bcj2307/Phase-encoding-a-reflector-array-using-open-and-short-circuited-loads/Report/LTSBEN001_Dissertation/Appendices/Repositories.tex

% ----------------------------------------------------
% Proofs
% ----------------------------------------------------
%\documentclass[class=report,11pt,crop=false]{standalone}
%\input{../Style/ChapterStyle.tex}
%\begin{document}
% ----------------------------------------------------
\chapter{Repository Locations}
% ----------------------------------------------------
All code designed for this project can be found at the following link:

\begin{center}
    \url{https://github.com/bcj2307/Phase-encoding-a-reflector-array-using-open-and-short-circuited-loads/tree/main/MATLAB}
\end{center}

\vspace{1cm}

All CST simulation used for the antenna design for this project can be found at the following link:

\begin{center}
    \url{https://github.com/bcj2307/Phase-encoding-a-reflector-array-using-open-and-short-circuited-loads/tree/main/CST}
\end{center}

\vspace{1cm}

All Altium files used for the manufacturing of the antenna can be found at the following link:

\begin{center}
    \url{https://github.com/bcj2307/Phase-encoding-a-reflector-array-using-open-and-short-circuited-loads/tree/main/Altium}
\end{center}

\vspace{1cm}

Furthermore, the \LaTeX~source code for this report, as well as the SVG and PDF diagrams that were designed and included, can be found at:

\begin{center}
    \url{https://github.com/bcj2307/Phase-encoding-a-reflector-array-using-open-and-short-circuited-loads/tree/main/Report}
\end{center}
% ----------------------------------------------------
\ifstandalone
% \bibliography{../Bibliography/References.bib}
% \printnoidxglossary[type=\acronymtype,nonumberlist]
\fi
%\end{document}
% ----------------------------------------------------
