bcj2307/Phase-encoding-a-reflector-array-using-open-and-short-circuited-loads/Report/LTSBEN001_Dissertation/FrontMatter/Title.tex

\thispagestyle{empty}
\begin{center}
    
\Huge

\vspace{5cm}

% Title
Phase encoding a reflector array using open and short-circuited loads

\vspace{2.5cm}

% UCT logo
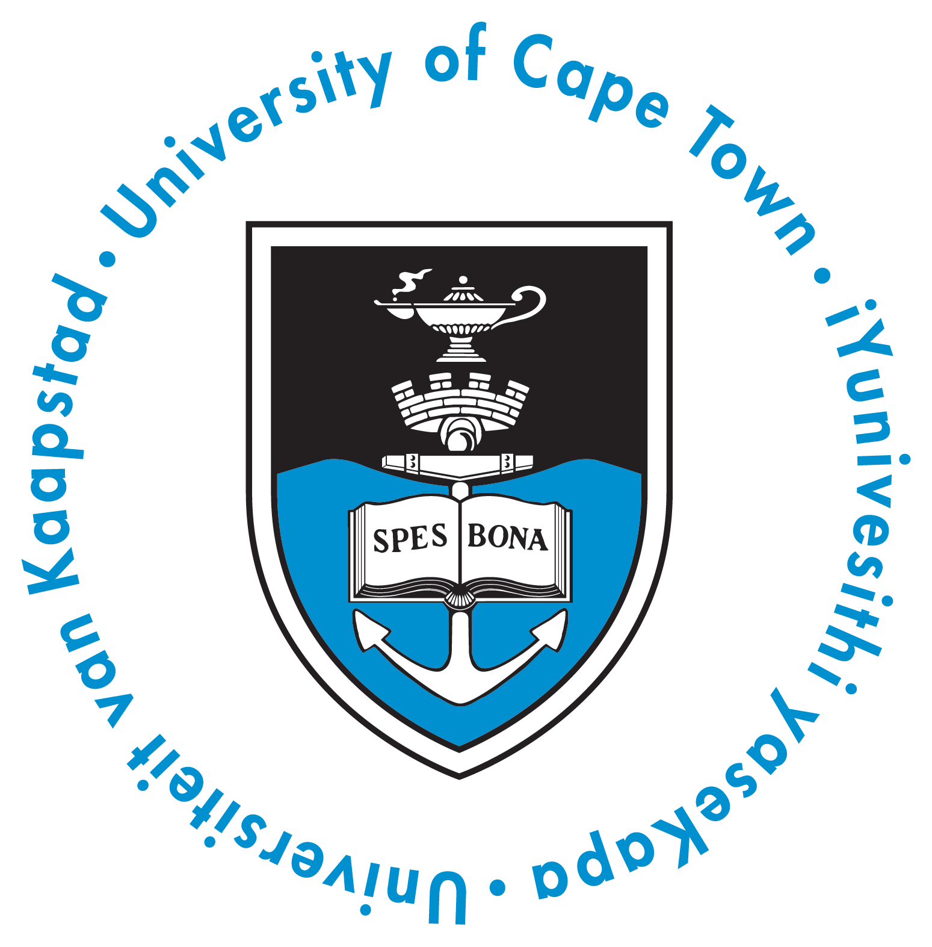
[picture p65: Report/LTSBEN001_Dissertation/FrontMatter/UCT_logo.png]


\vfill

% My name
\large
\textbf{Prepared by:}\\
Benco Loots

\vspace{1cm}

% My supervisor's name
\textbf{Prepared for:}\\
Dr Stephen Paine\\
Department of Electrical Engineering\\
University of Cape Town

\vspace{2cm}

% My Degree
\small
Submitted to the Department of Electrical Engineering at the University of Cape Town\\
in partial fulfilment of the academic requirements for a\\
MEng Master of Engineering Specialising in Radar

\vspace{2cm}

% Today's date
\today

% To add keywords?
% \vspace{2cm}
% \textbf{Keywords:} Passive Radar, Digital Audio Broadcasting

\end{center}
