bcj2307/Phase-encoding-a-reflector-array-using-open-and-short-circuited-loads/Report/LTSBEN001_Dissertation/Main.tex

\documentclass[11pt]{report}
\input{Style/ChapterStyle.tex}
\usepackage{standalone} % Best loaded last in the preamble
\usepackage{float}

\begin{document}

\pagenumbering{roman}
\input{FrontMatter/Title.tex}
\input{FrontMatter/Declaration.tex}
\input{FrontMatter/Acknowledgements.tex}
\input{FrontMatter/Abstract.tex}
\glsresetall

\tableofcontents
\listoffigures
\listoftables

%\input{FrontMatter/Glossary.tex}
%\printnoidxglossary[type=\acronymtype,nonumberlist,title={Abbreviations}]
\input{FrontMatter/Abbreviations}

\newpage

\pagenumbering{arabic}

\input{Chapters/Introduction.tex}
\input{Chapters/Literature.tex}
\input{Chapters/Design.tex}
\input{Chapters/Results.tex}
\input{Chapters/Conclusions.tex}
%\input{Chapters/Recommendations.tex}

\newpage
\bibliography{Bibliography/References.bib}

\appendix
\input{Appendices/Repositories.tex}

%\input{Appendices/Proofs.tex}

\end{document}
