bcj2307/Phase-encoding-a-reflector-array-using-open-and-short-circuited-loads/Report/LTSBEN001_Dissertation/Appendices/Proofs.tex

% ----------------------------------------------------
% Proofs
% ----------------------------------------------------
%\documentclass[class=report,11pt,crop=false]{standalone}
%\input{../Style/ChapterStyle.tex}
%\input{../FrontMatter/Glossary.tex}
%\begin{document}
% ----------------------------------------------------
\chapter{MATLAB Script\label{sec:MATLAB}}
% ----------------------------------------------------

% ----------------------------------------------------
\ifstandalone
% \bibliography{../Bibliography/References.bib}
\printnoidxglossary[type=\acronymtype,nonumberlist]
\fi
%\end{document}
% ----------------------------------------------------
