bcj2307/Phase-encoding-a-reflector-array-using-open-and-short-circuited-loads/Report/LTSBEN001_Dissertation/Figures/chp3_CPW_edge_port.png

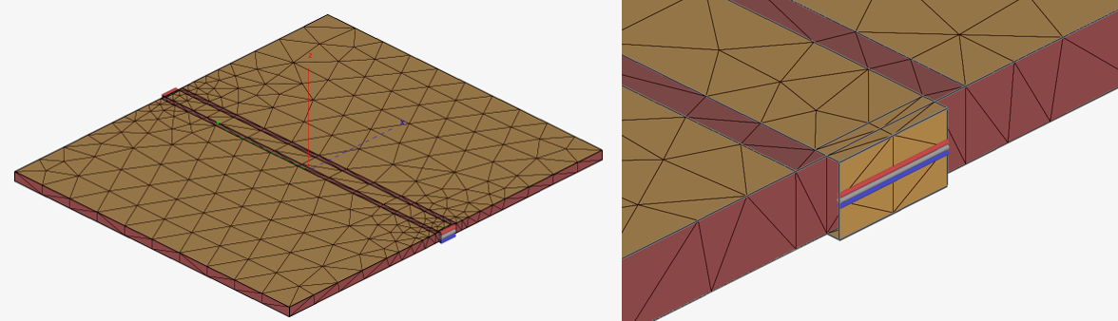
Report/LTSBEN001_Dissertation/Figures/chp3_CPW_edge_port.png
