bcj2307/Phase-encoding-a-reflector-array-using-open-and-short-circuited-loads/Report/LTSBEN001_Dissertation/Figures/chp3_linear_array.png

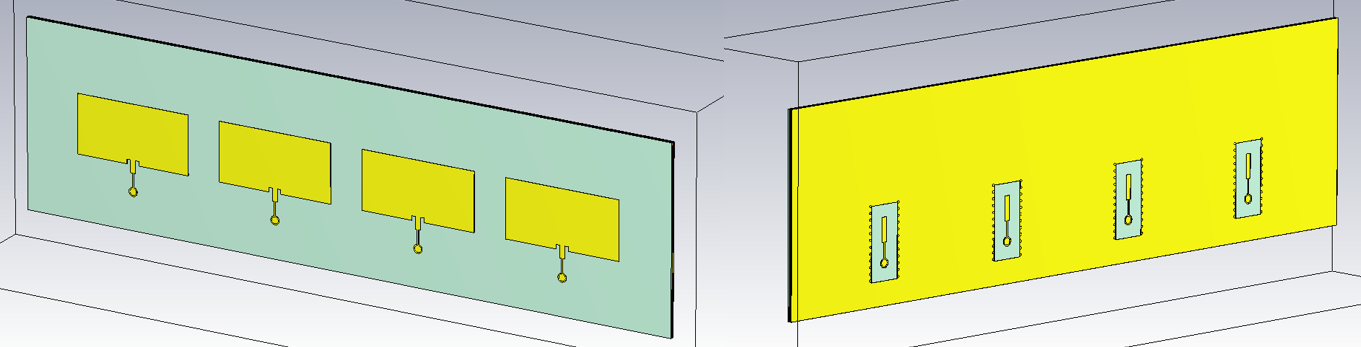
Report/LTSBEN001_Dissertation/Figures/chp3_linear_array.png
