bcj2307/Phase-encoding-a-reflector-array-using-open-and-short-circuited-loads/Report/LTSBEN001_Dissertation/Figures/chp3_linear_array_adjacent_coupling.png

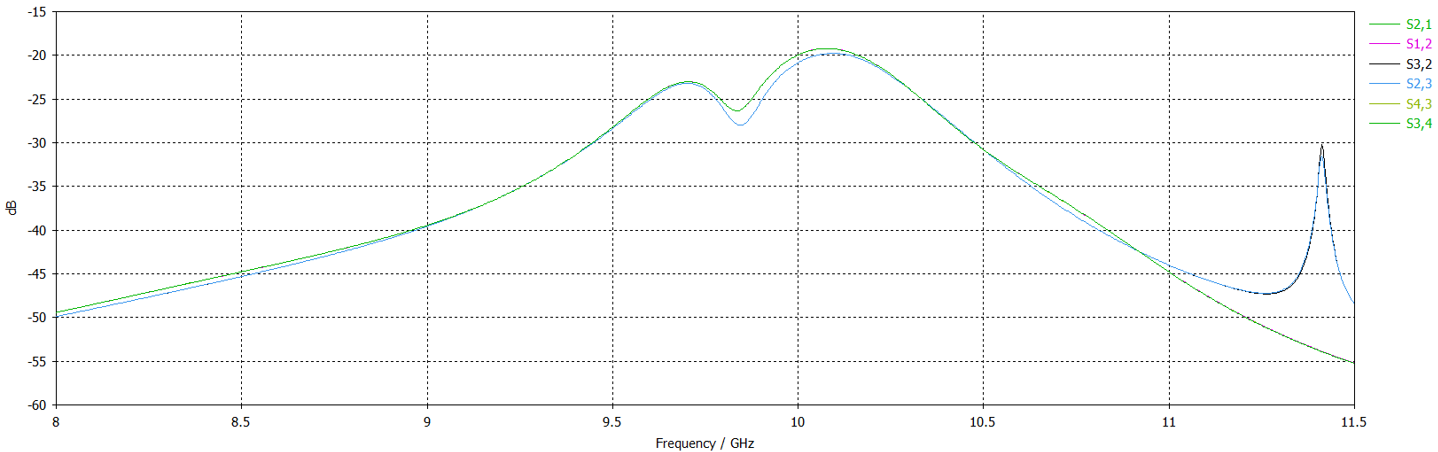
Report/LTSBEN001_Dissertation/Figures/chp3_linear_array_adjacent_coupling.png
