bcj2307/Phase-encoding-a-reflector-array-using-open-and-short-circuited-loads/Report/LTSBEN001_Dissertation/Figures/chp4_Raw_phase.png

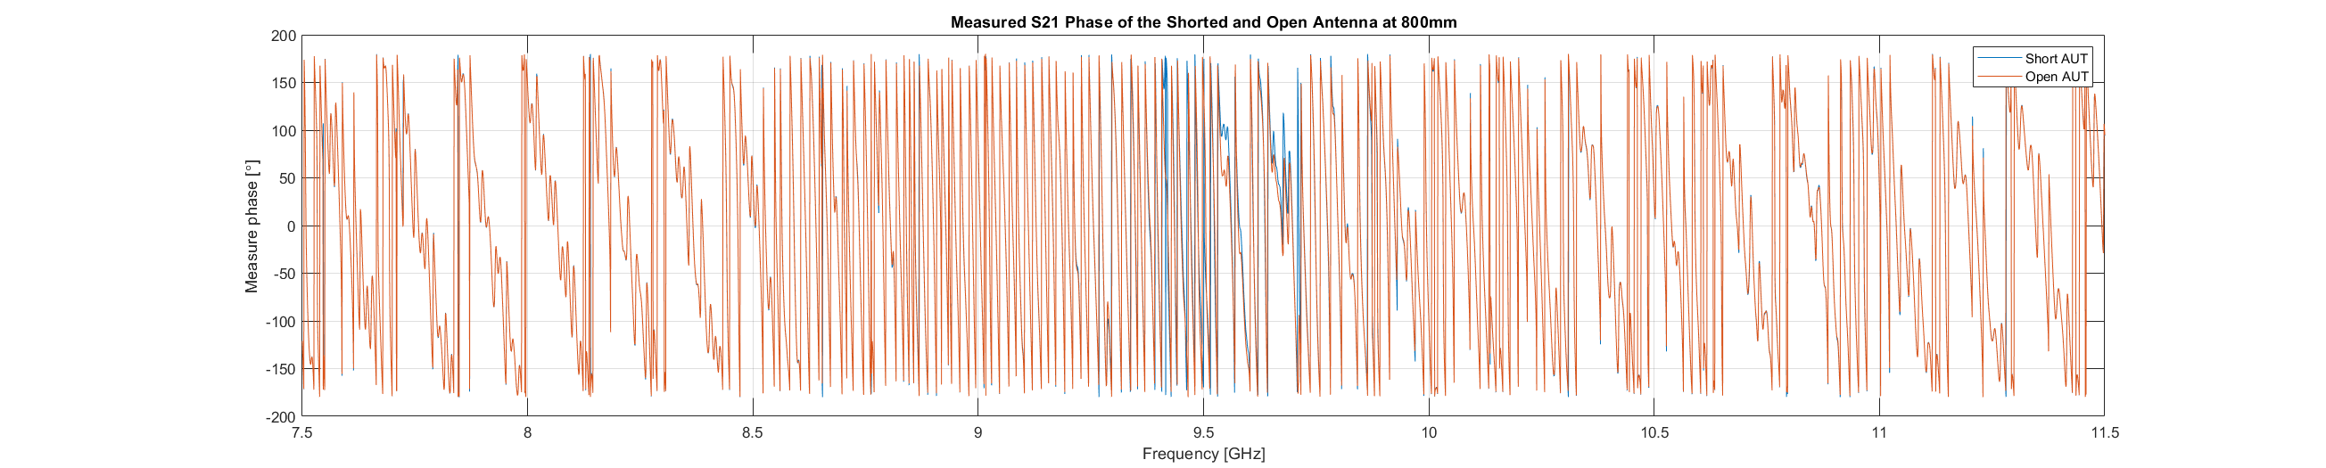
Report/LTSBEN001_Dissertation/Figures/chp4_Raw_phase.png
