bcj2307/Phase-encoding-a-reflector-array-using-open-and-short-circuited-loads/Altium/02 - Manufacturing/EQ for EEE5004ZAntenna.xls

Sheet: DFM
Engineering Questions Confirm Letter
(PN): |  | EEE5004Z Antenna |  | (JOB): |  | M450239
(Linkman): |  | Dave |  | (Date): |  | 2025-03-11 14:10:06
Note: in order to ensure product delivery time, please confirm and reply in a timely manner.Thank you very much!
(Item) | (EQ Type) | (Question Describe) | (Suggestion) | (Annex) | (Customer Reply) |  | (Customer remarks)
2 | Copper | The designed copper extends to the edge of the board. It will cause copper exposure and burr if we follow Gerber. | Suggestion A: Shave copper 0.25mm away from the outline to avoid copper exposure. Suggestion B: Follow Gerber to build, exposed copper and burr are both acceptable. Please choose A or B, the one you think is better. | 2.JPG | A
3 | stamp hole | As shown in the "3.JPG", the stamp holes are on the copper foil of the L3 and L4 layers. Please confirm how to deal with it? | Allow us to shave copper 0.2mm away from the stamp holes to avoid copper exposure. | 3.JPG | Accepted
5 | Gold thickness | The surface treatment thickness is 0.005mm in your stackup. This gold thickness is too thick and we cannot achieve it. We recommend following the IPC 4552 standard, with a gold thickness of 2-4U" and a nickel thickness of 118-236U". Please confirm. | Follow the IPC 4552 standard, and the gold thickness 2-4U" and nickel thickness of 118-236U" is approved. | 5.JPG | Accepted
8 | solder mask | It requires to print white solder mask on the bottom side, but there is no solder mask file in your provided Gerber. Please confirm. | Ignore the solder mask requirements, does not print solder mask ink for this board. | 8.JPG | Accepted
9 | Working Gerber | Please help confirm the attached working Gerber. | Our working Gerber is approved, and we will follow it to build the board. |  | Accepted
Please update your original gerber in archive if adjustments of gerber design involved base on above communication results. Thanks!
IF a customer can not reply EQ betore 12 pm the day after order release date. the lead time calculation will start ftom the next day of EQ closure.

Sheet: 3.JPG
返回（Return） EQs
原稿 | 削铜后的效果如下图所示（注意削铜后的连接位上铜皮断开的）

Sheet: 5.JPG
返回（Return） EQs

Sheet: 8.JPG
返回（Return） EQs
