bcj2307/Phase-encoding-a-reflector-array-using-open-and-short-circuited-loads/Report/LTSBEN001_Dissertation/Chapters/Results.tex

% ----------------------------------------------------
% Theory
% ----------------------------------------------------
%\documentclass[class=report,11pt,crop=false]{standalone}
%\input{../Style/ChapterStyle.tex}
%\input{../FrontMatter/Glossary.tex}
%\begin{document}
\ifstandalone
\tableofcontents
\fi
% ----------------------------------------------------
\chapter{Testing \& Results \label{ch:results}}
%\epigraph{Nobody can build you the bridge over which you must cross the river of life, nobody but you alone.}%
%    {\emph{---Friedrich Nietzsche}}
\vspace{0.5cm}
% ----------------------------------------------------

\section{Test setup \& Equipment}

    \begin{figure}[H]
    \centering
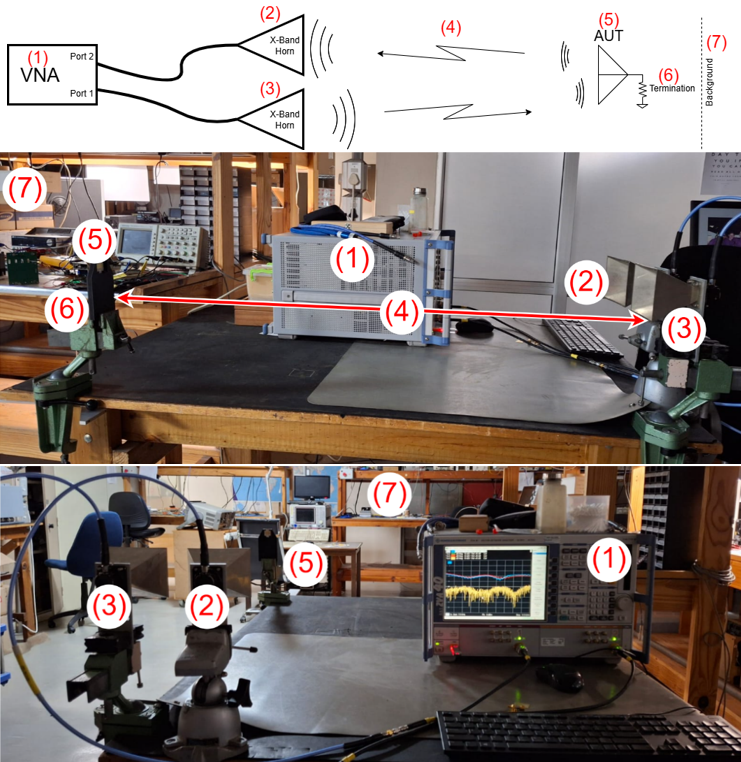
[picture p83: Report/LTSBEN001_Dissertation/Figures/chp4_setup.png]
    
    \caption{Test Setup.}
    \label{fig:chp4_setup}
    \end{figure}

Figure \ref{fig:chp4_setup} show the labelled block diagram of the test setup along with the labelled physical test setup used for all the measurements in this section.
\begin{enumerate}
    \item The Rohde \& Schwarz ZVA 40 VNA was used. This a 2 port \(10MHz-40GHz\) VNA.
    \item This is one of two identical reflective covered injection moulded X-band horn antennae. This antenna acts as the transmit antenna. Since the signal measured will be extremely small in magnitude a horn antenna was chosen for the high gain and directivity.
    \item This is the other X-band horn antennae that was used as the receive antenna. The center of the aperture of the horn antennae are aligned.
    \item The AUT must be placed in the Farfield region of all the antennae. Since the X-Band horn antenna have the largest aperture, the min distance will be the were the Farfield of the horn antennae start.
    \item The AUT is placed in the design bracket and the bracket does not move for a set of measurements. The bracket is designed to keep the position of the AUT fixed when swapping the antennae. The center of the patch is aligned with the aperture of the horn antennae.
    \item Instead of changing the termination of each measurement, three different antennae are used with a termination connect. See figure \ref{fig:chp4_AUTs} below.
    \item Since the measurement were done in the laboratory of a Radar company, the measurements were done after hours and all other equipment in the laboratory was switched off. 
\end{enumerate}

    \begin{figure}[H]
    \centering
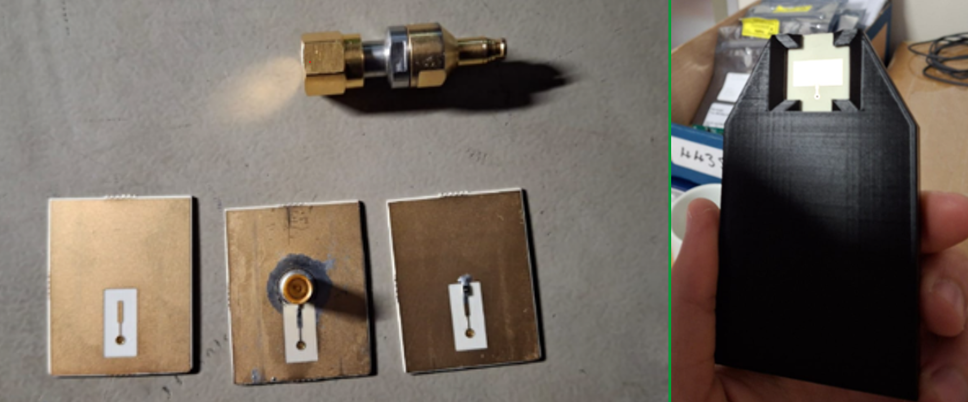
[picture p84: Report/LTSBEN001_Dissertation/Figures/chp4_AUTs.png]
    
    \caption{Three different AUT used during testing.}
    \label{fig:chp4_AUTs}
    \end{figure}

Before the investigation can be done with the design patch antenna, the antenna design must first be verified. The measured return loss of the connectorized antenna is seen in figure \ref{fig:chp4_AUT_S11} below. Although the deep null of -40dB is not seen, the return loss of -19.5dB at the center frequency is still a well-designed antenna. The center frequency is also lower by a 98MHz which equates to a difference in antenna width of $\pm$200um or antenna length of $\pm$90um according to CST studio simulations.

    \begin{figure}[H]
    \centering
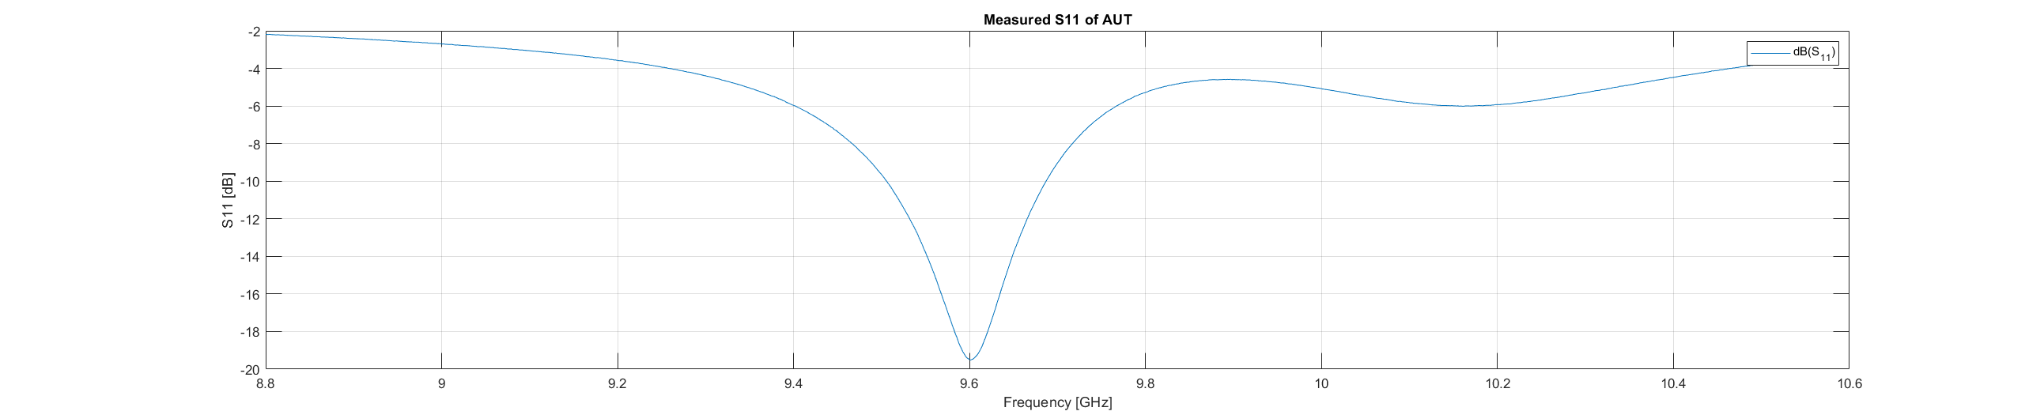
[picture p85: Report/LTSBEN001_Dissertation/Figures/chp4_AUT_S11.png]
    
    \caption{Measured return loss of the design patch (AUT).}
    \label{fig:chp4_AUT_S11}
    \end{figure}

\section{Results}
The test procedure involves moving the AUT into the Farfield of the X-Band horn antennae then doing three separate measurements. One with the open load antenna, a second with the short-circuited antenna a third with the SMP antenna with a SMA 50Ω termination connected to it. The Farfield region of the X-Band horn is calculated below as 584mm. At set of measurements were done with the AUT 600mm, 700mm, 800mm and 900mm away from the horn antennae.
    \[R_{ff}=\frac{2D^2}{\lambda}=\frac{2{(95mm)}^2}{30.91mm}=584mm\]

Analyzing the raw \(S_{21}\) data for the 800mm measurements, as seen in figure \ref{fig:chp4_Raw_results} below, the measured magnitude is the same for both the short circuit and the open circuit AUT. The only visible difference is near the center frequency of the AUT. The same is seen in figure \ref{fig:chp4_Raw_results} for the measured \(S_{21}\) phases of the short circuit and open circuit AUT. 

    \begin{figure}[H]
    \centering
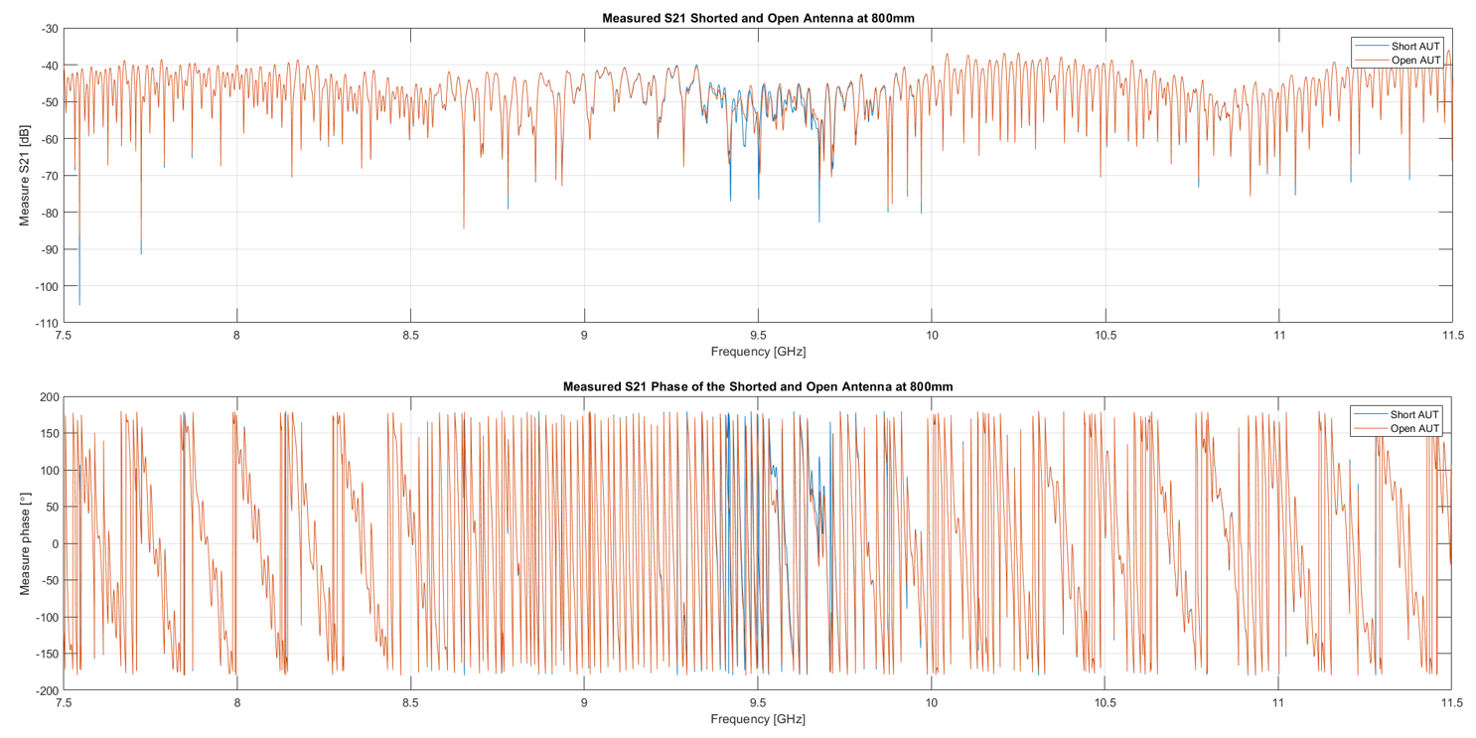
[picture p86: Report/LTSBEN001_Dissertation/Figures/chp4_Raw_results.png]
    
    \caption{Measured \(S_{21}\) magnitude \& phase.}
    \label{fig:chp4_Raw_results}
    \end{figure}

Figure \ref{fig:chp4_Raw_difference_results} below show the zoomed-in view of figure \ref{fig:chp4_Raw_results} as well as the phase difference between the short circuit and open circuit AUT of the measured and unprocessed \(S_{21}\). It is clear that the maximum difference occurs close to the center frequency, which is the opposite response that is aimed for. The following section details the results of the signal processing required for the proposed system in section \ref{sec:objectives}.

    \begin{figure}[H]
    \centering
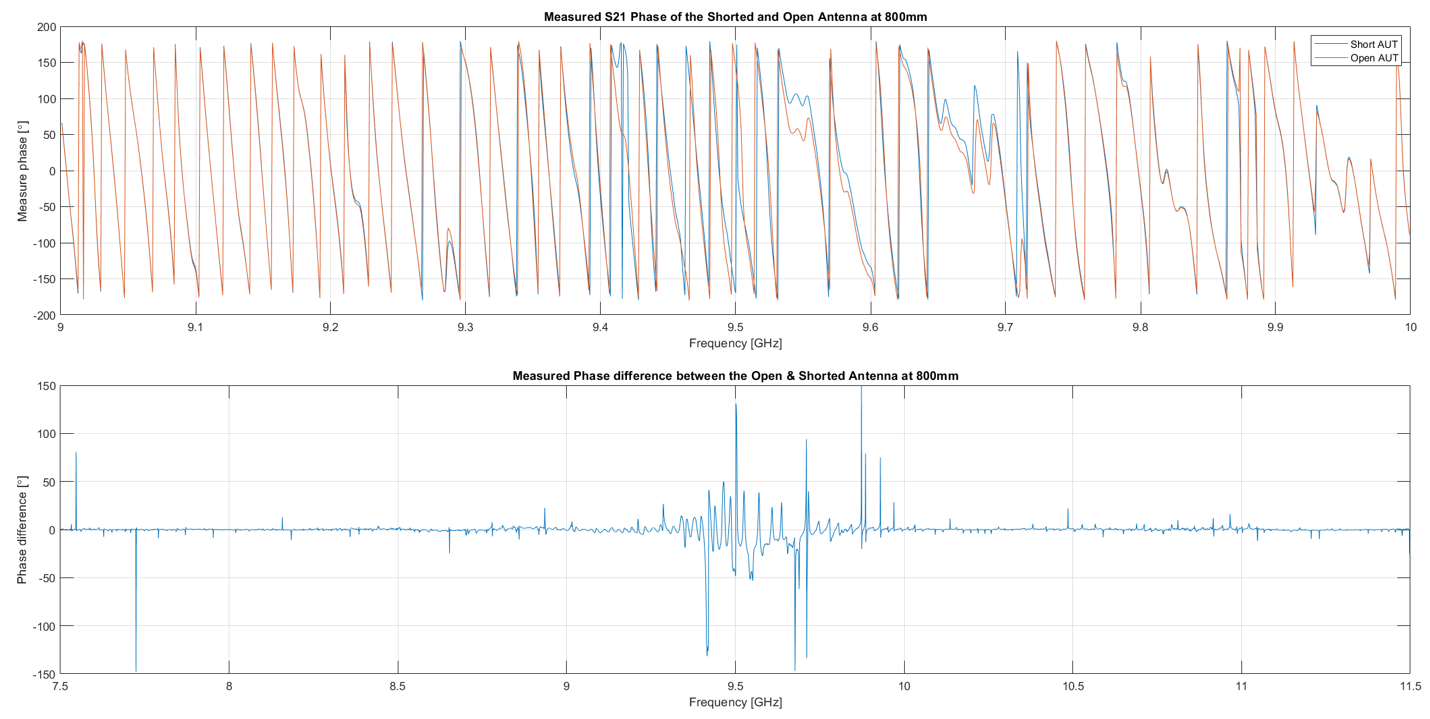
[picture p87: Report/LTSBEN001_Dissertation/Figures/chp4_Raw_difference_results.png]
    
    \caption{Measured and unprocessed phase difference between the open and short AUT.}
    \label{fig:chp4_Raw_difference_results}
    \end{figure}

Figure \ref{fig:chp4_Raw_smith} below shows the \(S_{21}\) at the center frequency plotted on the smith chart. Since the power loss from the transmit horn antenna through the test setup to the receive antenna is high, the magnitude of the \(S_{21}\) is very low. Due to this all three \(S_{21}\) points are difficult to see, figure \ref{fig:chp4_Raw_smith} (bottom) shows the same plot with a scale of 0.0032.

    \begin{figure}[H]
    \centering
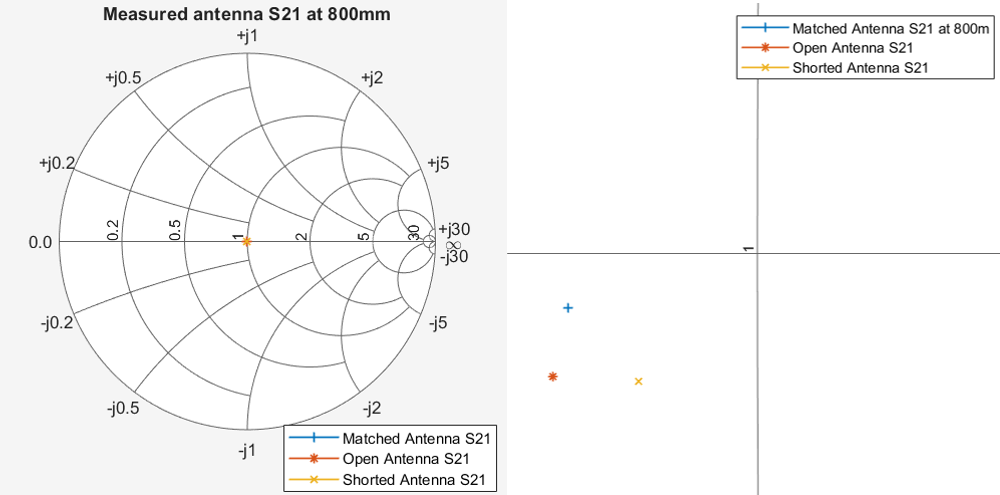
[picture p88: Report/LTSBEN001_Dissertation/Figures/chp4_Raw_smith.png]
    
    \caption{Measured and unprocessed \(S_{21}\) plotted on the smith chart.}
    \label{fig:chp4_Raw_smith}
    \end{figure}

For the proposed system in section \ref{sec:objectives}, it is assumed that the background and physical AUT remains constant for a given measurement. If that this assumption holds true, then the reflections received from the scene will be the same in the short circuit and open circuit measurement. Therefor this can be calibrated out. For the testing in this report the matched AUT should absorb all the received power into the 50$\Omega$ load and the received signal should only contain the reflections from the background and the physical structure of the AUT. Therefor all the measured \(S_{21}\) data is normalized to the matched \(S_{21}\) data as seen in figure \ref{fig:chp4_Calibrated_smith} below.

    \begin{figure}[H]
    \centering
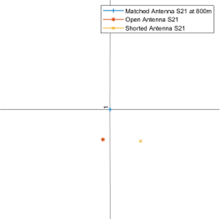
[picture p89: Report/LTSBEN001_Dissertation/Figures/chp4_Calibrated_smith.png]
    
    \caption{\(S_{21}\) normalized to the \(50\Omega S_{21}\) plotted on the smith chart.}
    \label{fig:chp4_Calibrated_smith}
    \end{figure}

Now that the short circuit and open circuit \(S_{21}\) has been normalized, the phase difference can be recalculated. Figure \ref{fig:chp4_Calibrated_difference_warpped_results} below shows the result over the entire measured frequency span. The spikes observed are due to the phase wrapping. Figure \ref{fig:chp4_Calibrated_difference_warpped_results}(bottom) show the result over the over the entire measured frequency span with the unwrapped phase.

    \begin{figure}[H]
    \centering
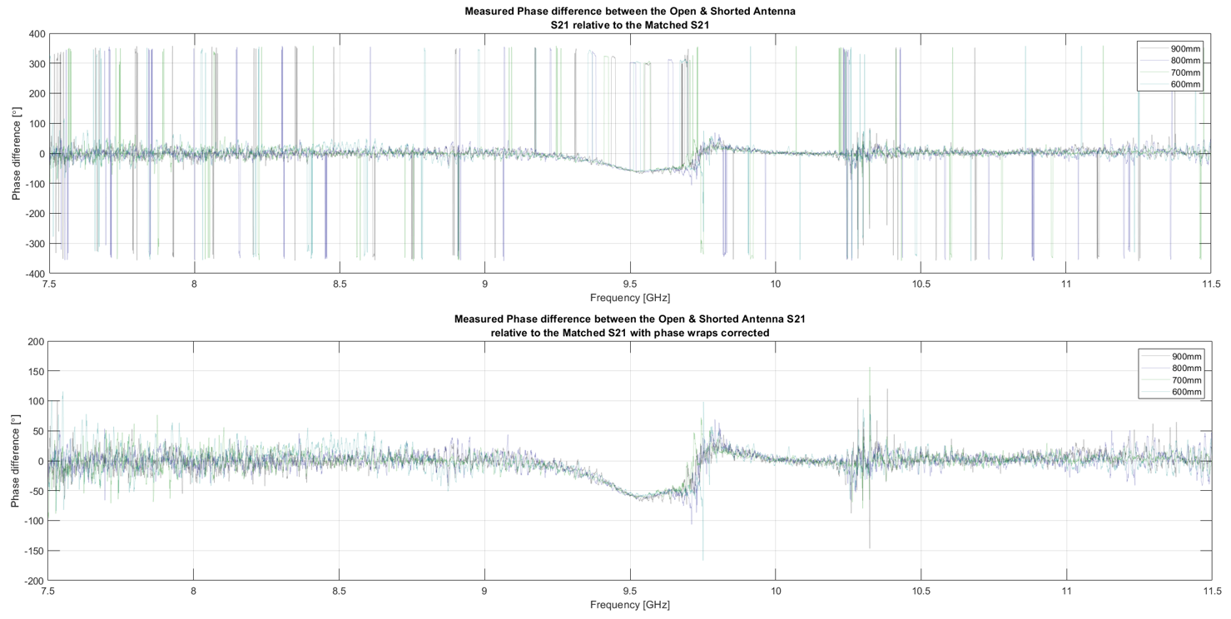
[picture p90: Report/LTSBEN001_Dissertation/Figures/chp4_Calibrated_difference_warpped_results.png]
    
    \caption{Encoded phase difference of the AUT normalized to the \(50\Omega \ S_{21}\).}
    \label{fig:chp4_Calibrated_difference_warpped_results}
    \end{figure}

It is undeniable that the phase difference becomes smaller the closer the measurement is to the center frequency. Figure \ref{fig:chp4_Calibrated_difference_zoom} below shows a zoomed-in plot of the phase difference. Using the antenna parameters as a guide the error calculations are done from 9.425-9.575GHz.

    \begin{figure}[H]
    \centering
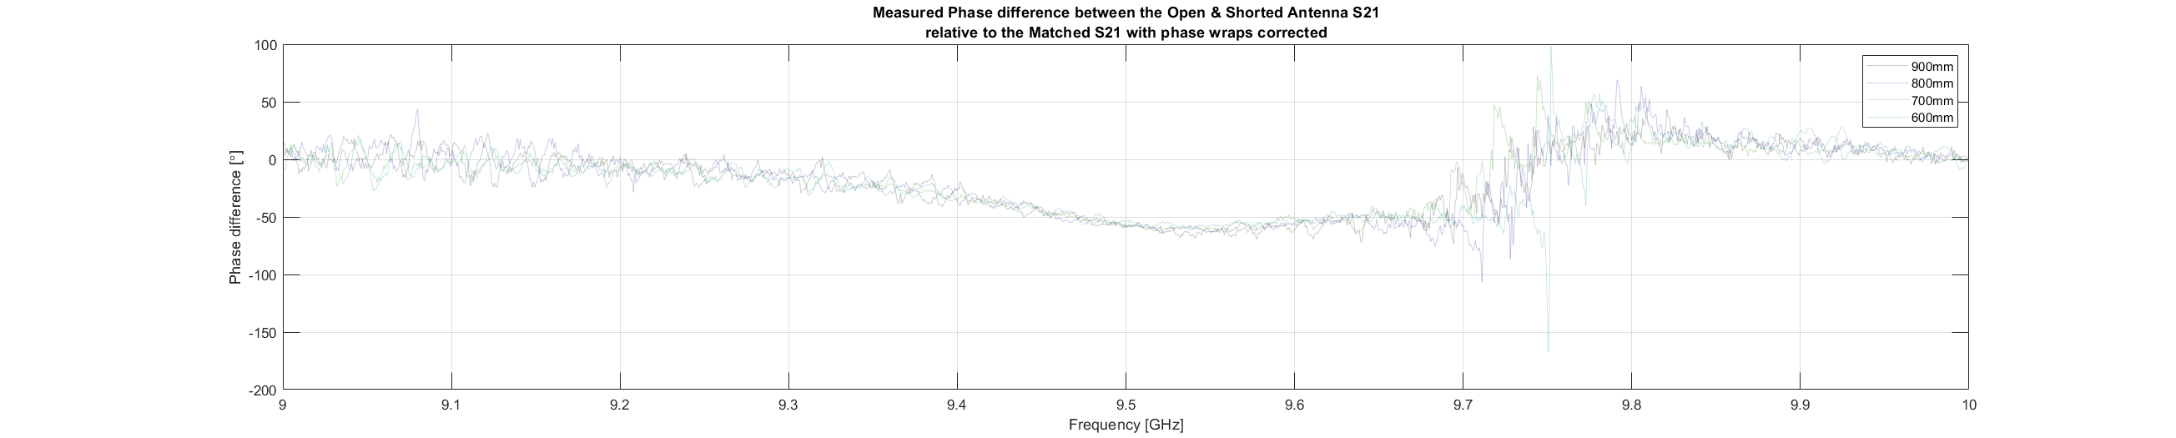
[picture p91: Report/LTSBEN001_Dissertation/Figures/chp4_Calibrated_difference_zoom.png]
    
    \caption{Zoomed-in plot of figure \ref{fig:chp4_Calibrated_difference_warpped_results}(bottom).}
    \label{fig:chp4_Calibrated_difference_zoom}
    \end{figure}

Figure \ref{fig:chp4_Calibrated_difference_results}(top) shows the mean of the four measurement sets over frequency along with the standard deviation from the mean over frequency (middle). The average of the mean is calculated as -53.71° and the average standard deviation is calculated as 2.66°. The phase error for each data set is seen in figure \ref{fig:chp4_Calibrated_difference_results}(bottom). The RMS phase error for each data set is noted in table \ref{tab:errorDay1}. These are very promising results, however the sample size is small and all four measurements set were recorded on the same say with the same environment. 

    \begin{table}[H]
    \centering
    \caption{Phase error of first set of measurements}
    \begin{tabular}{|l|r|} 
    \hline
    \textbf{Data set} & \textbf{RMS error [°]}   \\ 
    \hline
    900mm                 & 2.7193        \\ 
    \hline
    800mm                 & 2.7260     \\
    \hline
    700mm                 & 1.4218    \\
    \hline
    600mm                 & 2.9145     \\
    \hline
    \end{tabular}
    \label{tab:errorDay1}
    \end{table}

    \begin{figure}[H]
    \centering
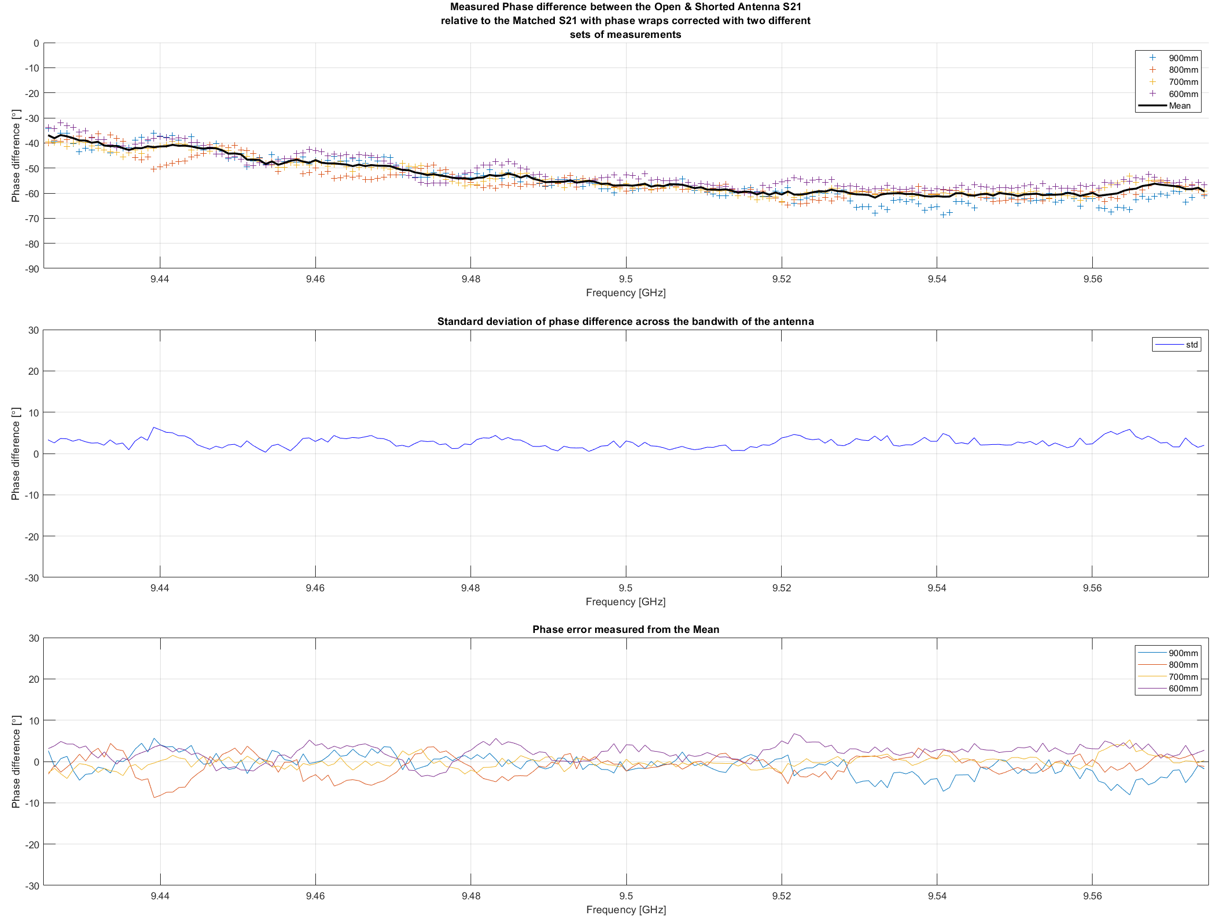
[picture p92: Report/LTSBEN001_Dissertation/Figures/chp4_Calibrated_difference_results.png]
    
    \caption{Mean, standard deviation and phase error of first set of measurements.}
    \label{fig:chp4_Calibrated_difference_results}
    \end{figure}

The tests are repeated two weeks after the original testing was completed to confirm that the results are correct and repeatable. Figure \ref{fig:chp4_Calibrated_smith_rept}(left) is from the first day of testing, figure \ref{fig:chp4_Calibrated_smith_rept}(right) is from the second day of testing. It is seen that the figure after normalizing to the \(50\Omega S_{21}\) the second measurement looks like a rotated version of the first measurement. The visual inspection is promising. 

    \begin{figure}[H]
    \centering
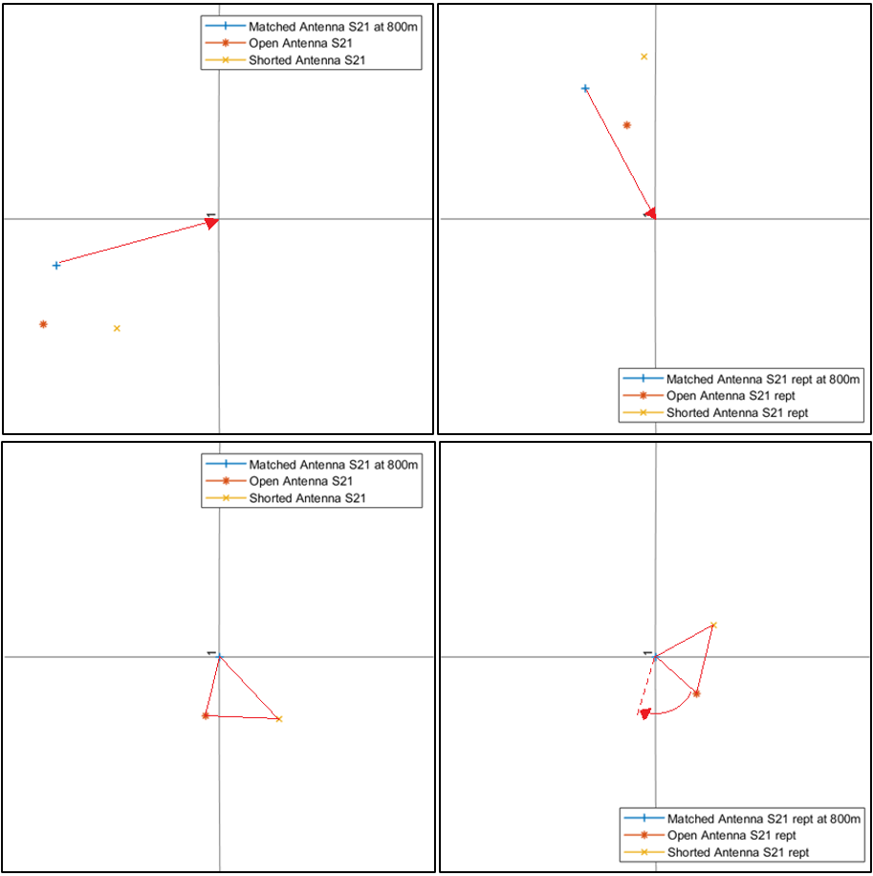
[picture p93: Report/LTSBEN001_Dissertation/Figures/chp4_Calibrated_smith_rept.png]
    
    \caption{First set \(S_{21}\) (left), Second set \(S_{21}\)(right).}
    \label{fig:chp4_Calibrated_smith_rept}
    \end{figure}

Figure \ref{fig:chp4_Calibrated_difference_rept_results} below shows the encoded phase difference between the short circuit and open circuit after being normalized to the matched \(S_{21}\). Figure  \ref{fig:chp4_Calibrated_difference_rept_results}(bottom) shows the same data overlayed over the first day of testing’s results. The response is similar, but slightly more sporadic.

    \begin{figure}[H]
    \centering
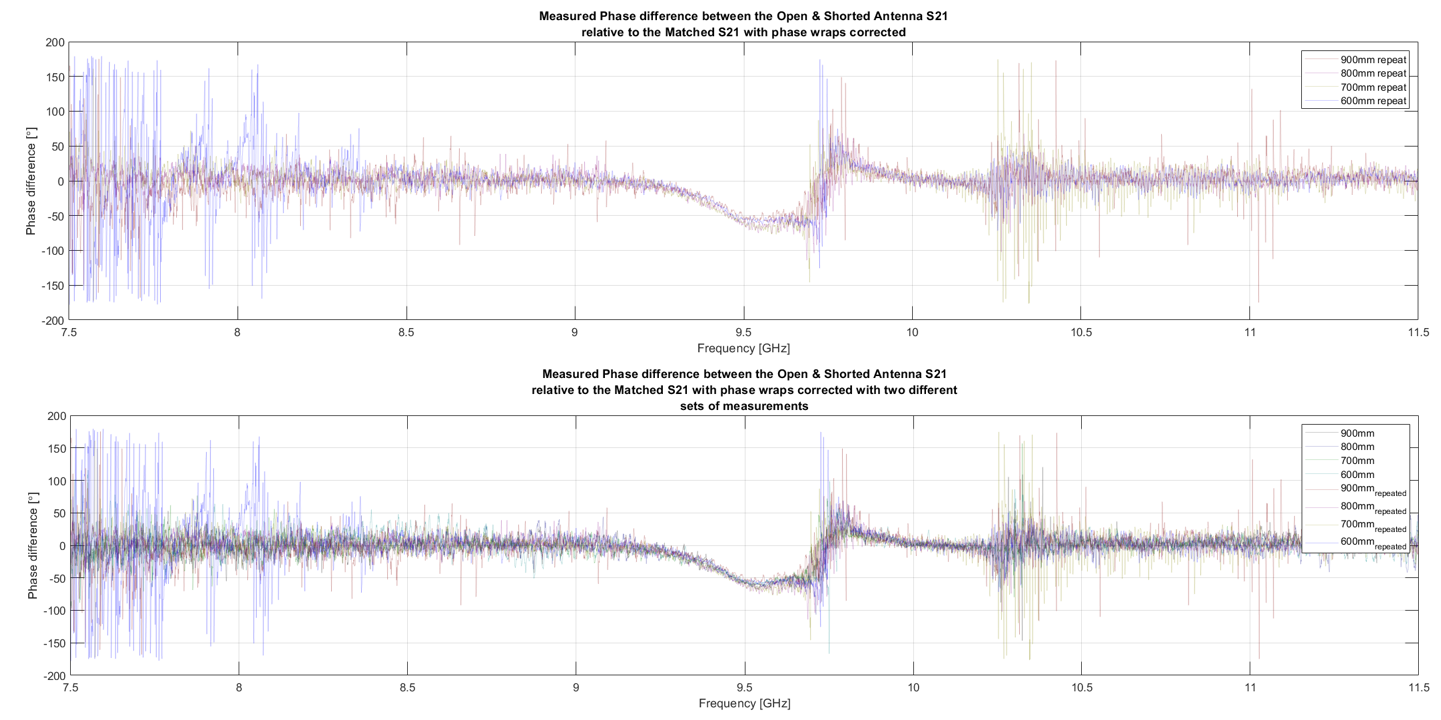
[picture p94: Report/LTSBEN001_Dissertation/Figures/chp4_Calibrated_difference_rept_results.png]
    
    \caption{Encoded phase difference of the AUT normalized to the \(50\Omega S_{21}\).}
    \label{fig:chp4_Calibrated_difference_rept_results}
    \end{figure}

Figure \ref{fig:chp4_Calibrated_difference_results_rept}(top) shows the recalculated mean of the all the measurement sets along with the recalculated and the original standard deviation from the mean (middle). The average of the mean is calculated as -54.06°, which is within 0.4° of the original mean. The average standard deviation is calculated as 4.19°, which has increased by 1.5° from the original standard deviation. The phase error for each data set is seen in figure \ref{fig:chp4_Calibrated_difference_results_rept}(bottom). The RMS phase error for each data set is noted in table \ref{tab:errorDay2} and a clear increase is observed.

    \begin{table}[H]
    \centering
    \caption{Phase error of all measurements}
    \begin{tabular}{|l|r|r|} 
    \hline
    \textbf{Data set} & \textbf{RMS error for day 1 [°]} & \textbf{RMS error for day 2 [°]}  \\ 
    \hline
    900mm                 & 2.7193    & 6.1314    \\ 
    \hline 
    800mm                 & 2.7260    & 5.0576 \\
    \hline
    700mm                 & 1.4218    & 5.2886  \\
    \hline
    600mm                 & 2.9145    & 3.1176  \\
    \hline
    \end{tabular}
    \label{tab:errorDay2}
    \end{table}

    \begin{figure}[H]
    \centering
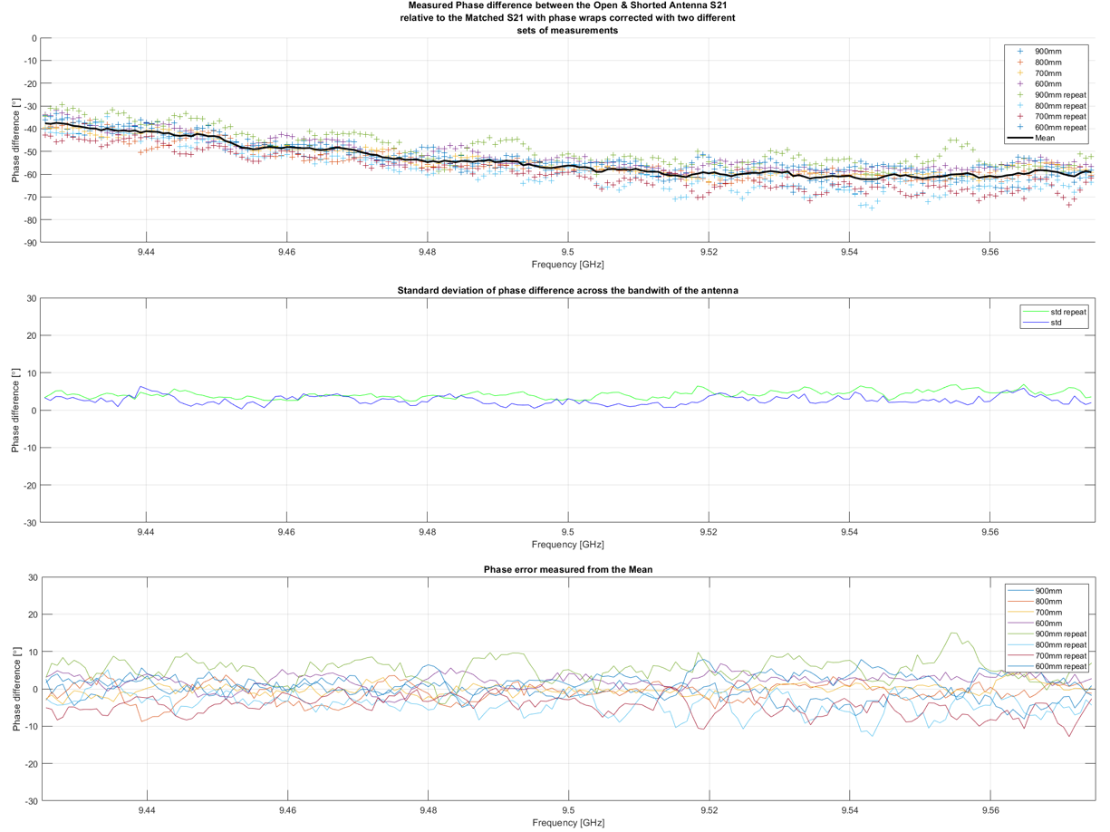
[picture p95: Report/LTSBEN001_Dissertation/Figures/chp4_Calibrated_difference_results_rept.png]
    
    \caption{Mean, standard deviation and phase error of all measurements.}
    \label{fig:chp4_Calibrated_difference_results_rept}
    \end{figure}

% ----------------------------------------------------
\ifstandalone
\bibliography{../Bibliography/References.bib}
\printnoidxglossary[type=\acronymtype,nonumberlist]
\fi
%\end{document}
% ----------------------------------------------------
