bcj2307/Phase-encoding-a-reflector-array-using-open-and-short-circuited-loads/Report/LTSBEN001_Dissertation/Figures/chp4_Calibrated_difference_error.png

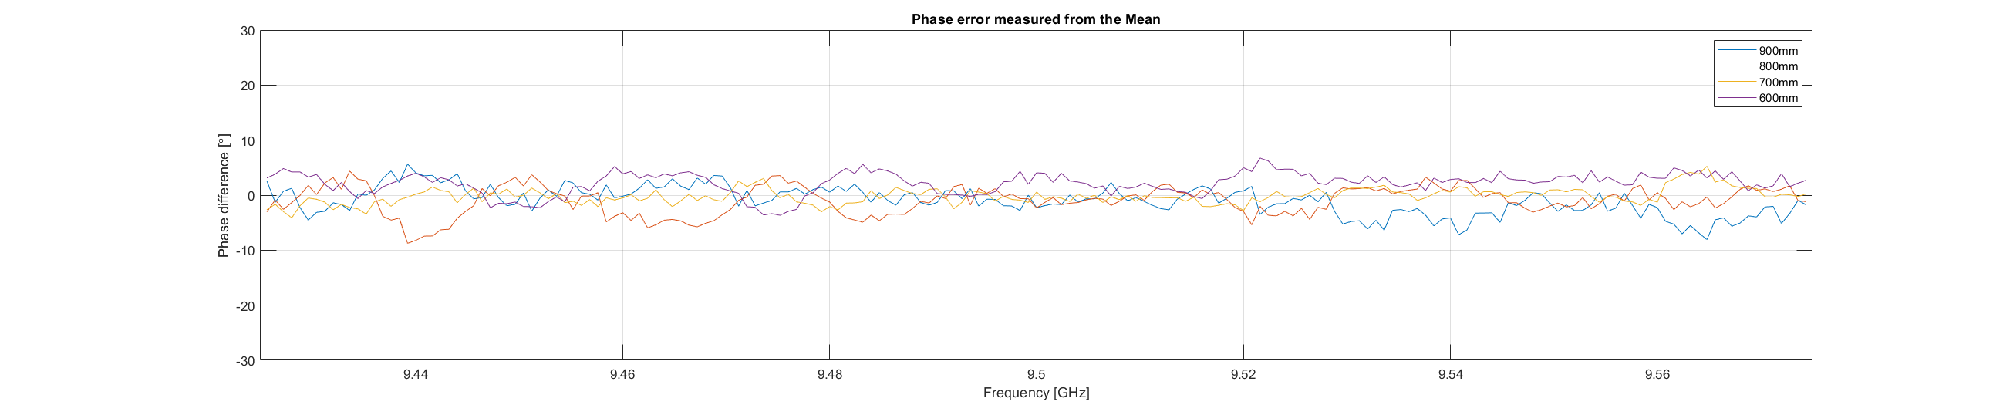
Report/LTSBEN001_Dissertation/Figures/chp4_Calibrated_difference_error.png
