bcj2307/Phase-encoding-a-reflector-array-using-open-and-short-circuited-loads/Altium/01 - Final/G3557_PLT/G3557_ASY.PDF

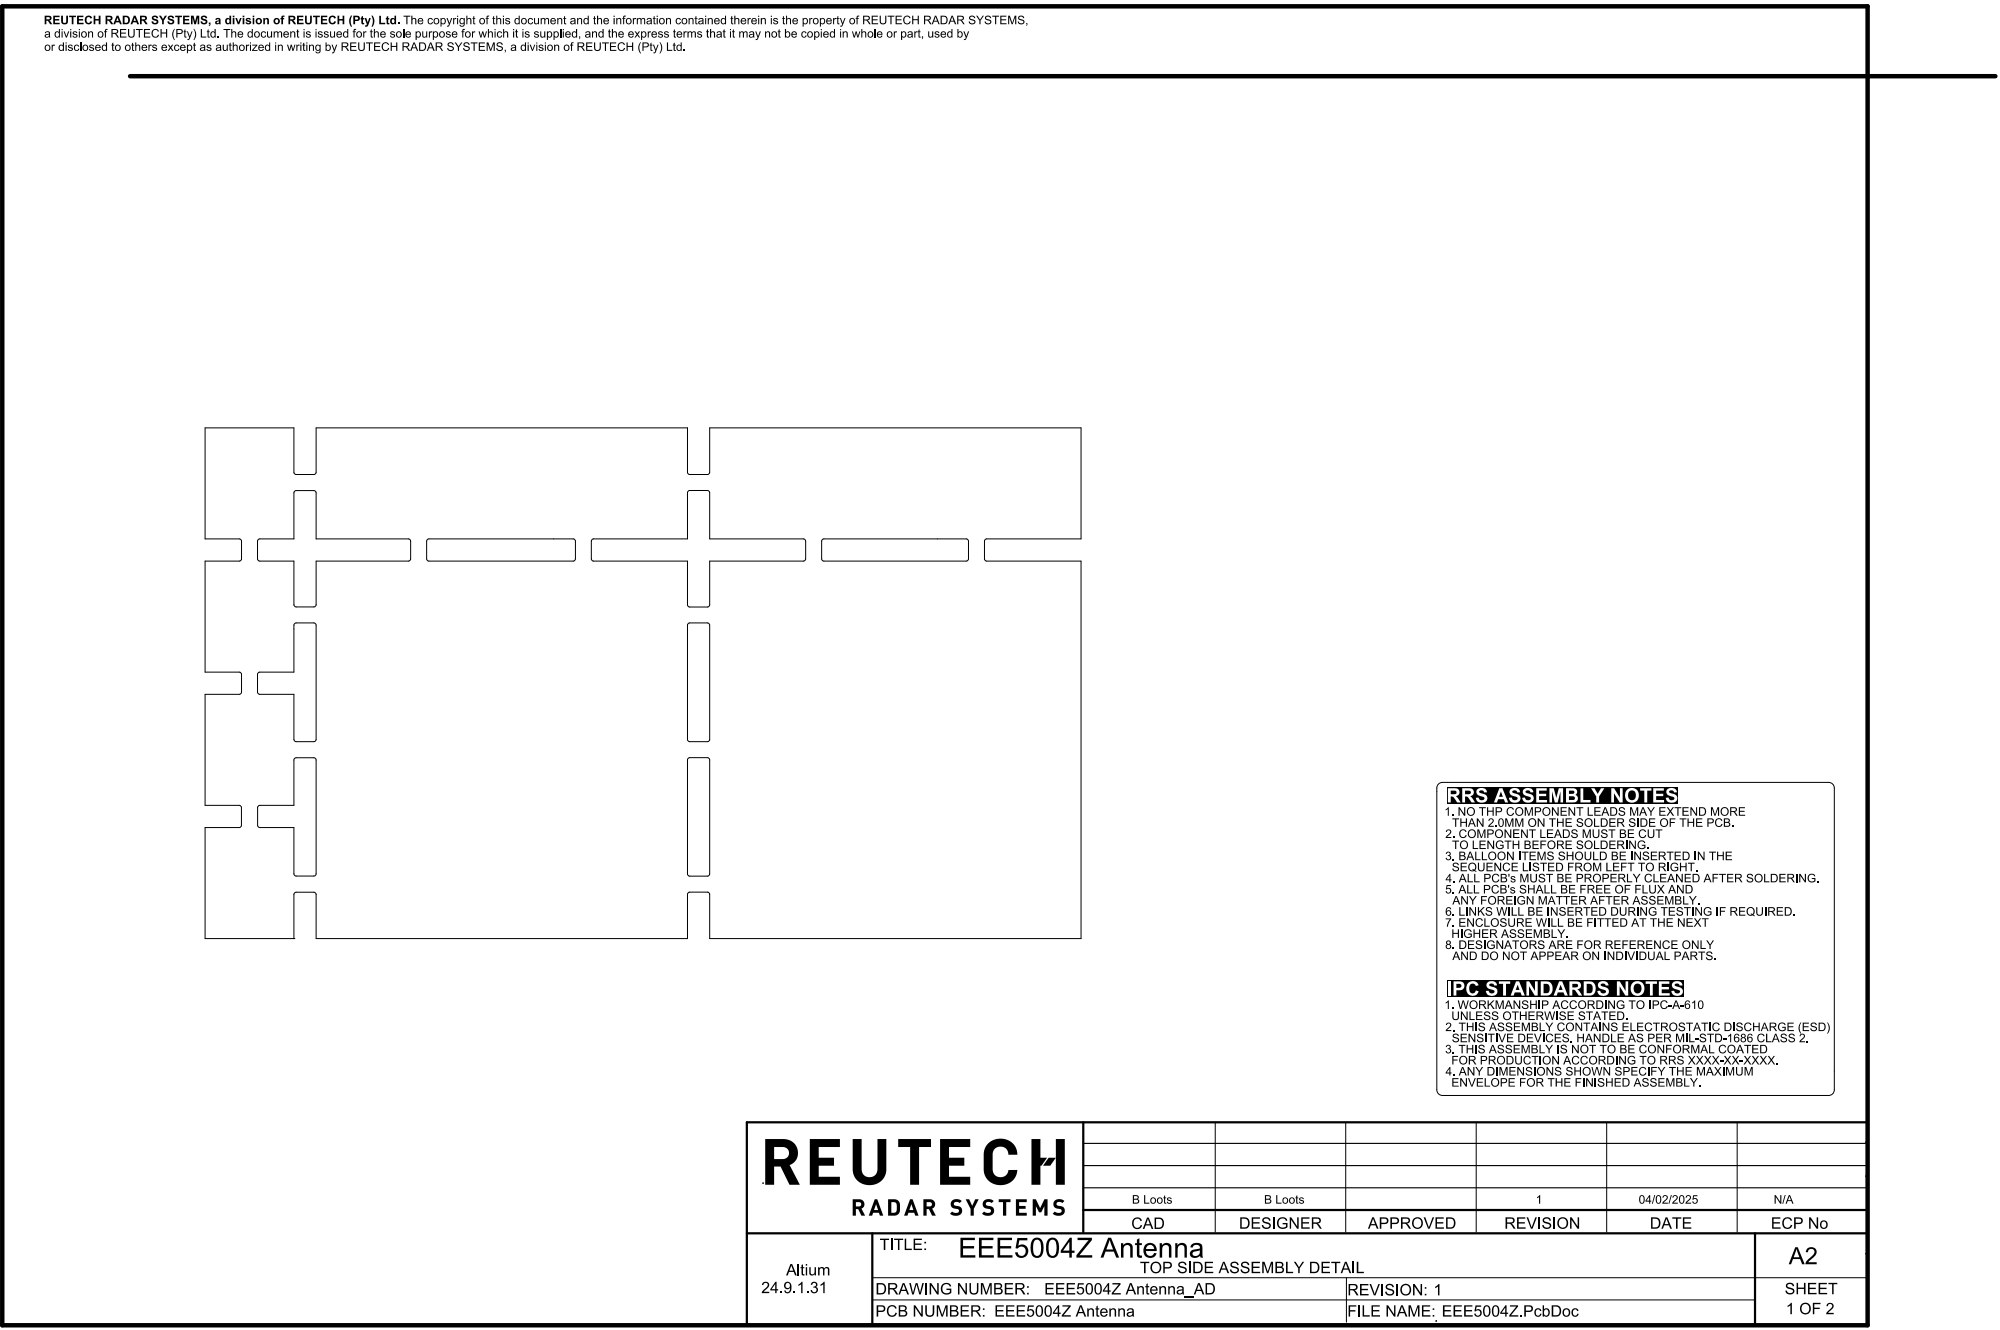
[picture p109: page 1]

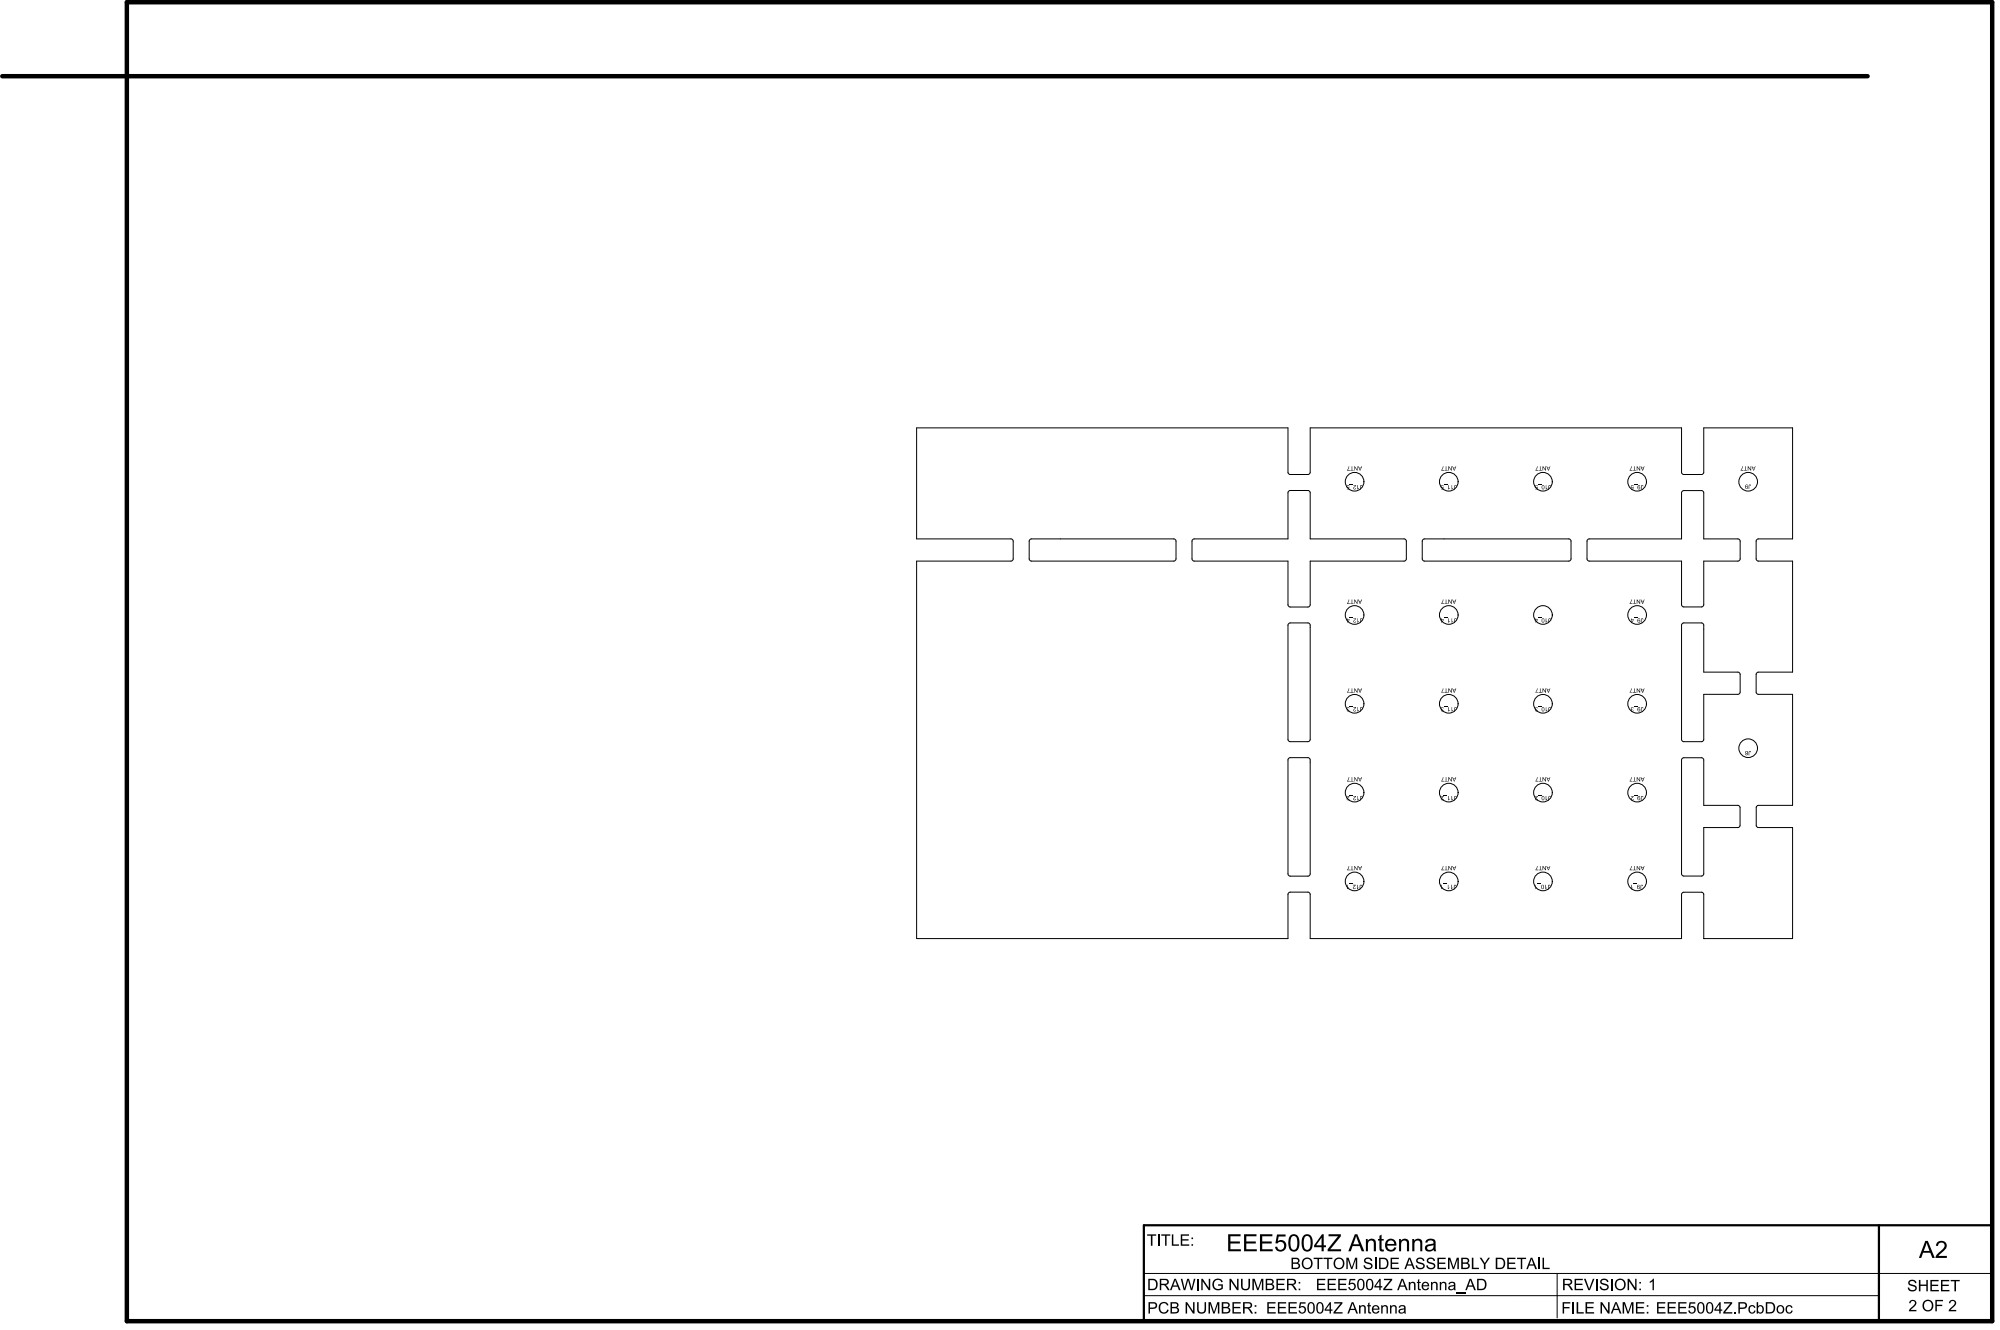
[picture p110: page 2]
