bcj2307/Phase-encoding-a-reflector-array-using-open-and-short-circuited-loads/Altium/01 - Final/G3557_PLT/G3557_P01.PDF

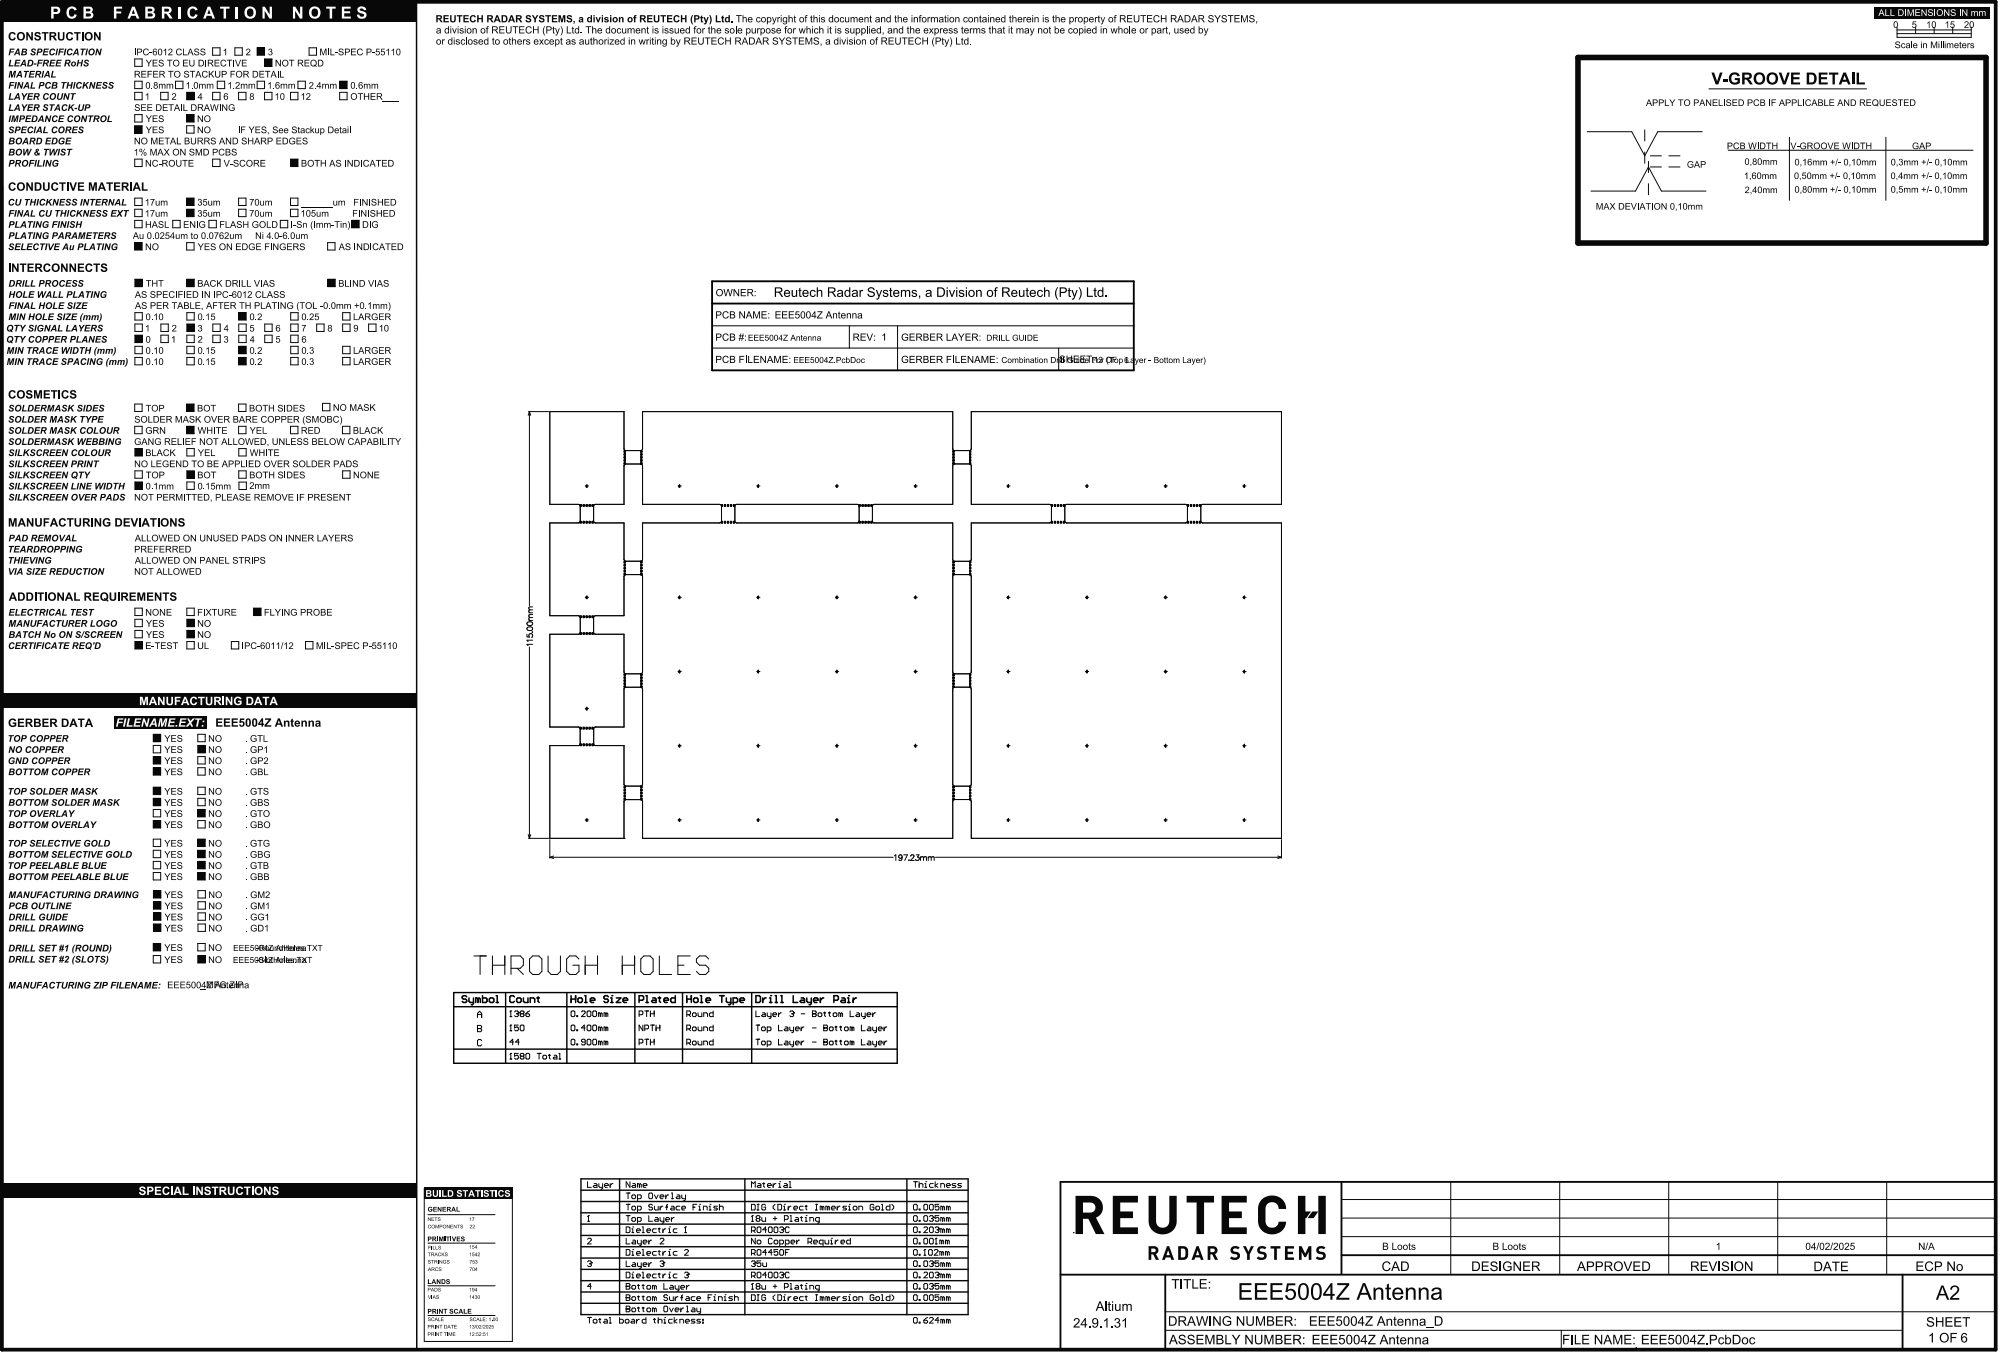
[picture p111: page 1]

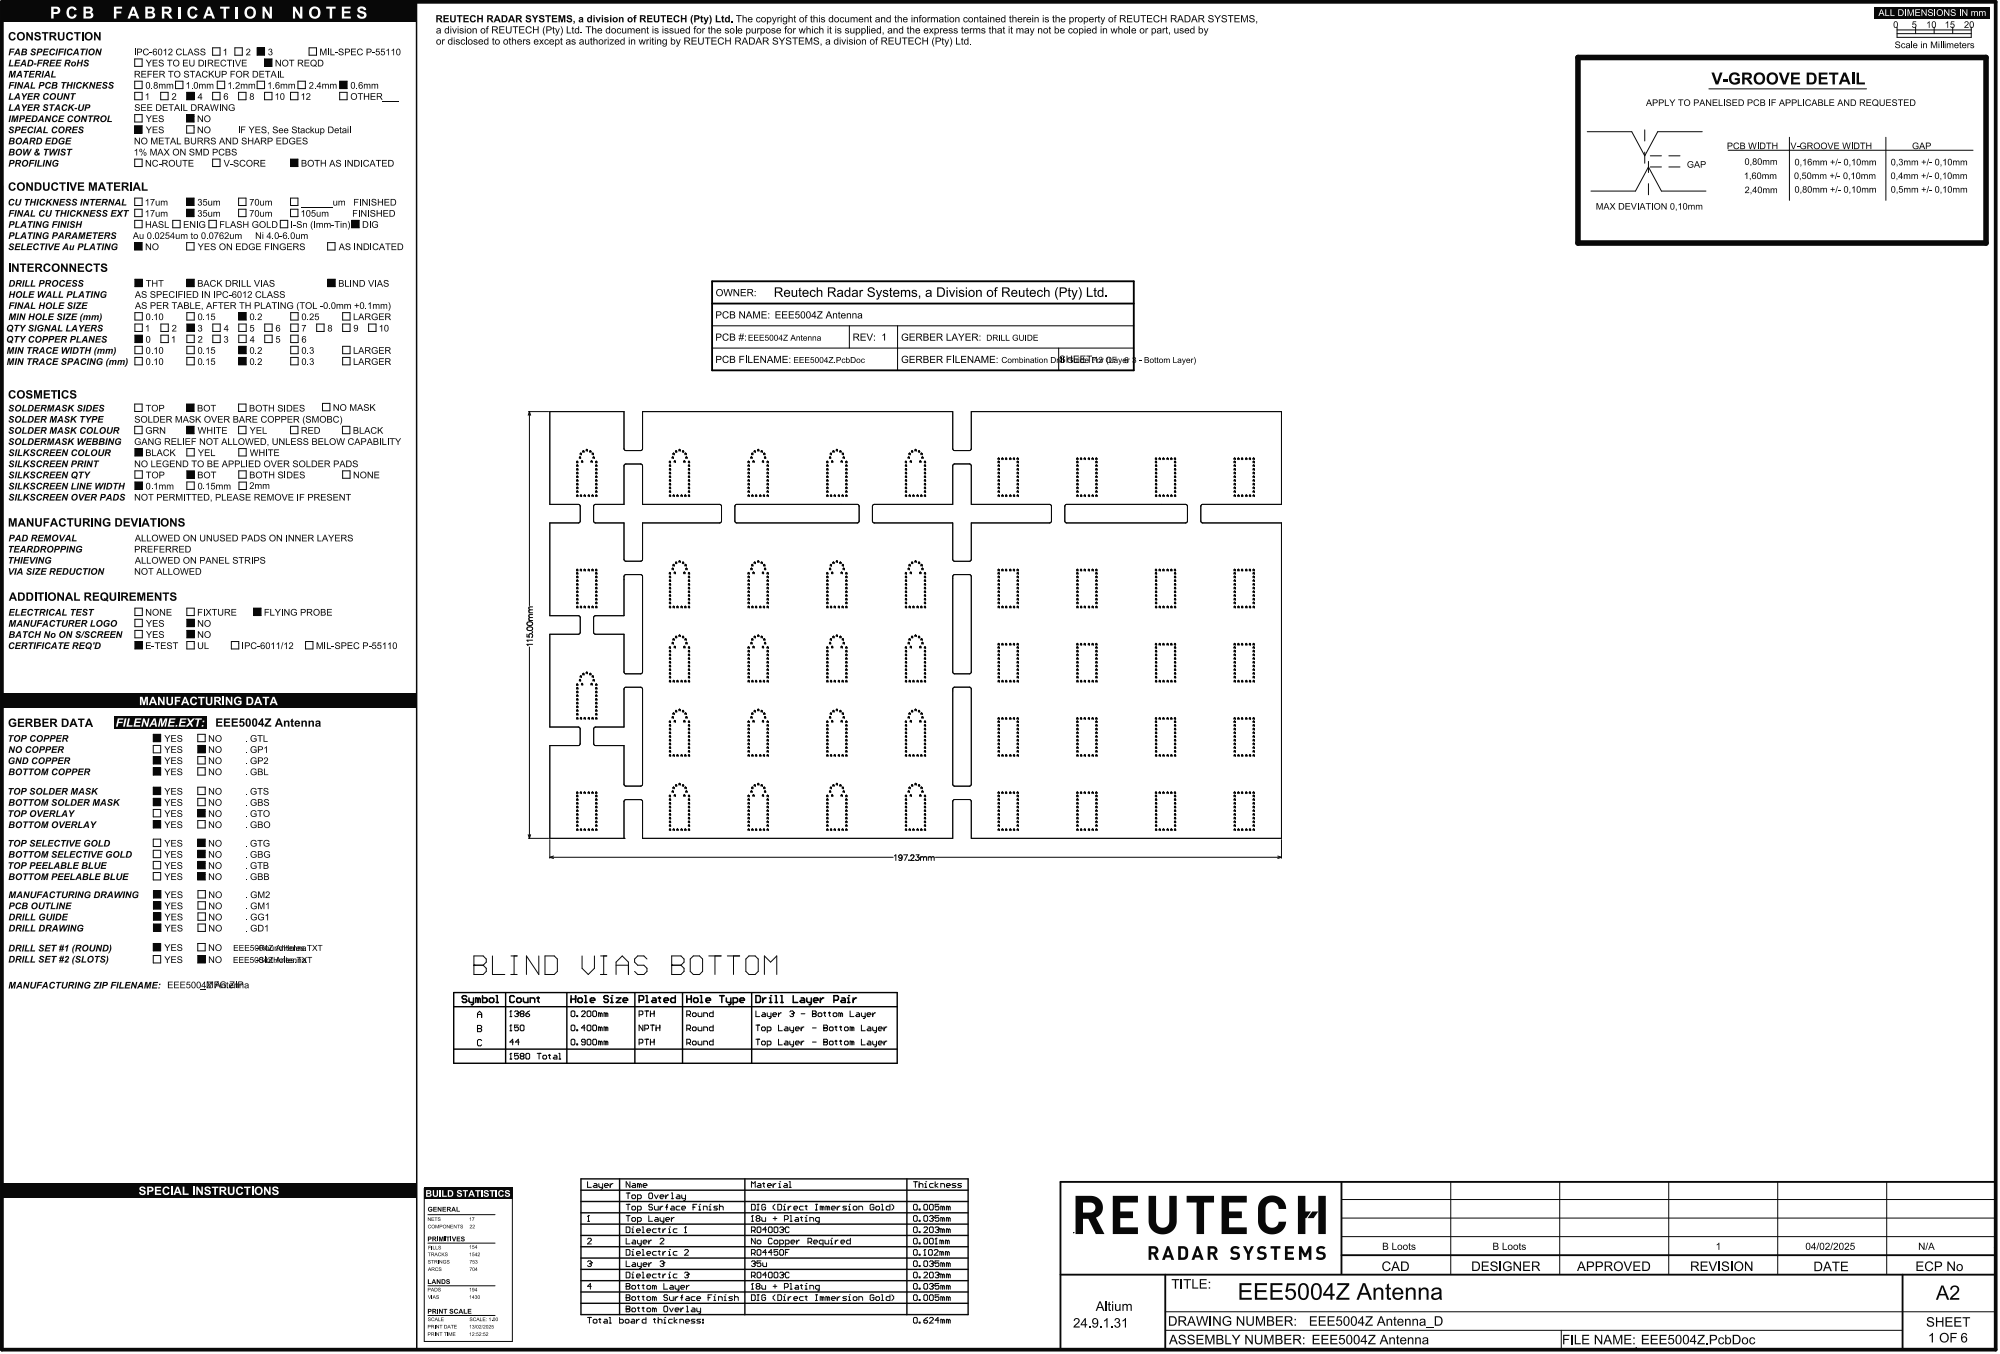
[picture p112: page 2]
