bcj2307/Phase-encoding-a-reflector-array-using-open-and-short-circuited-loads/Altium/01 - Final/G3557_PLT/G3557_P02 to P09.PDF

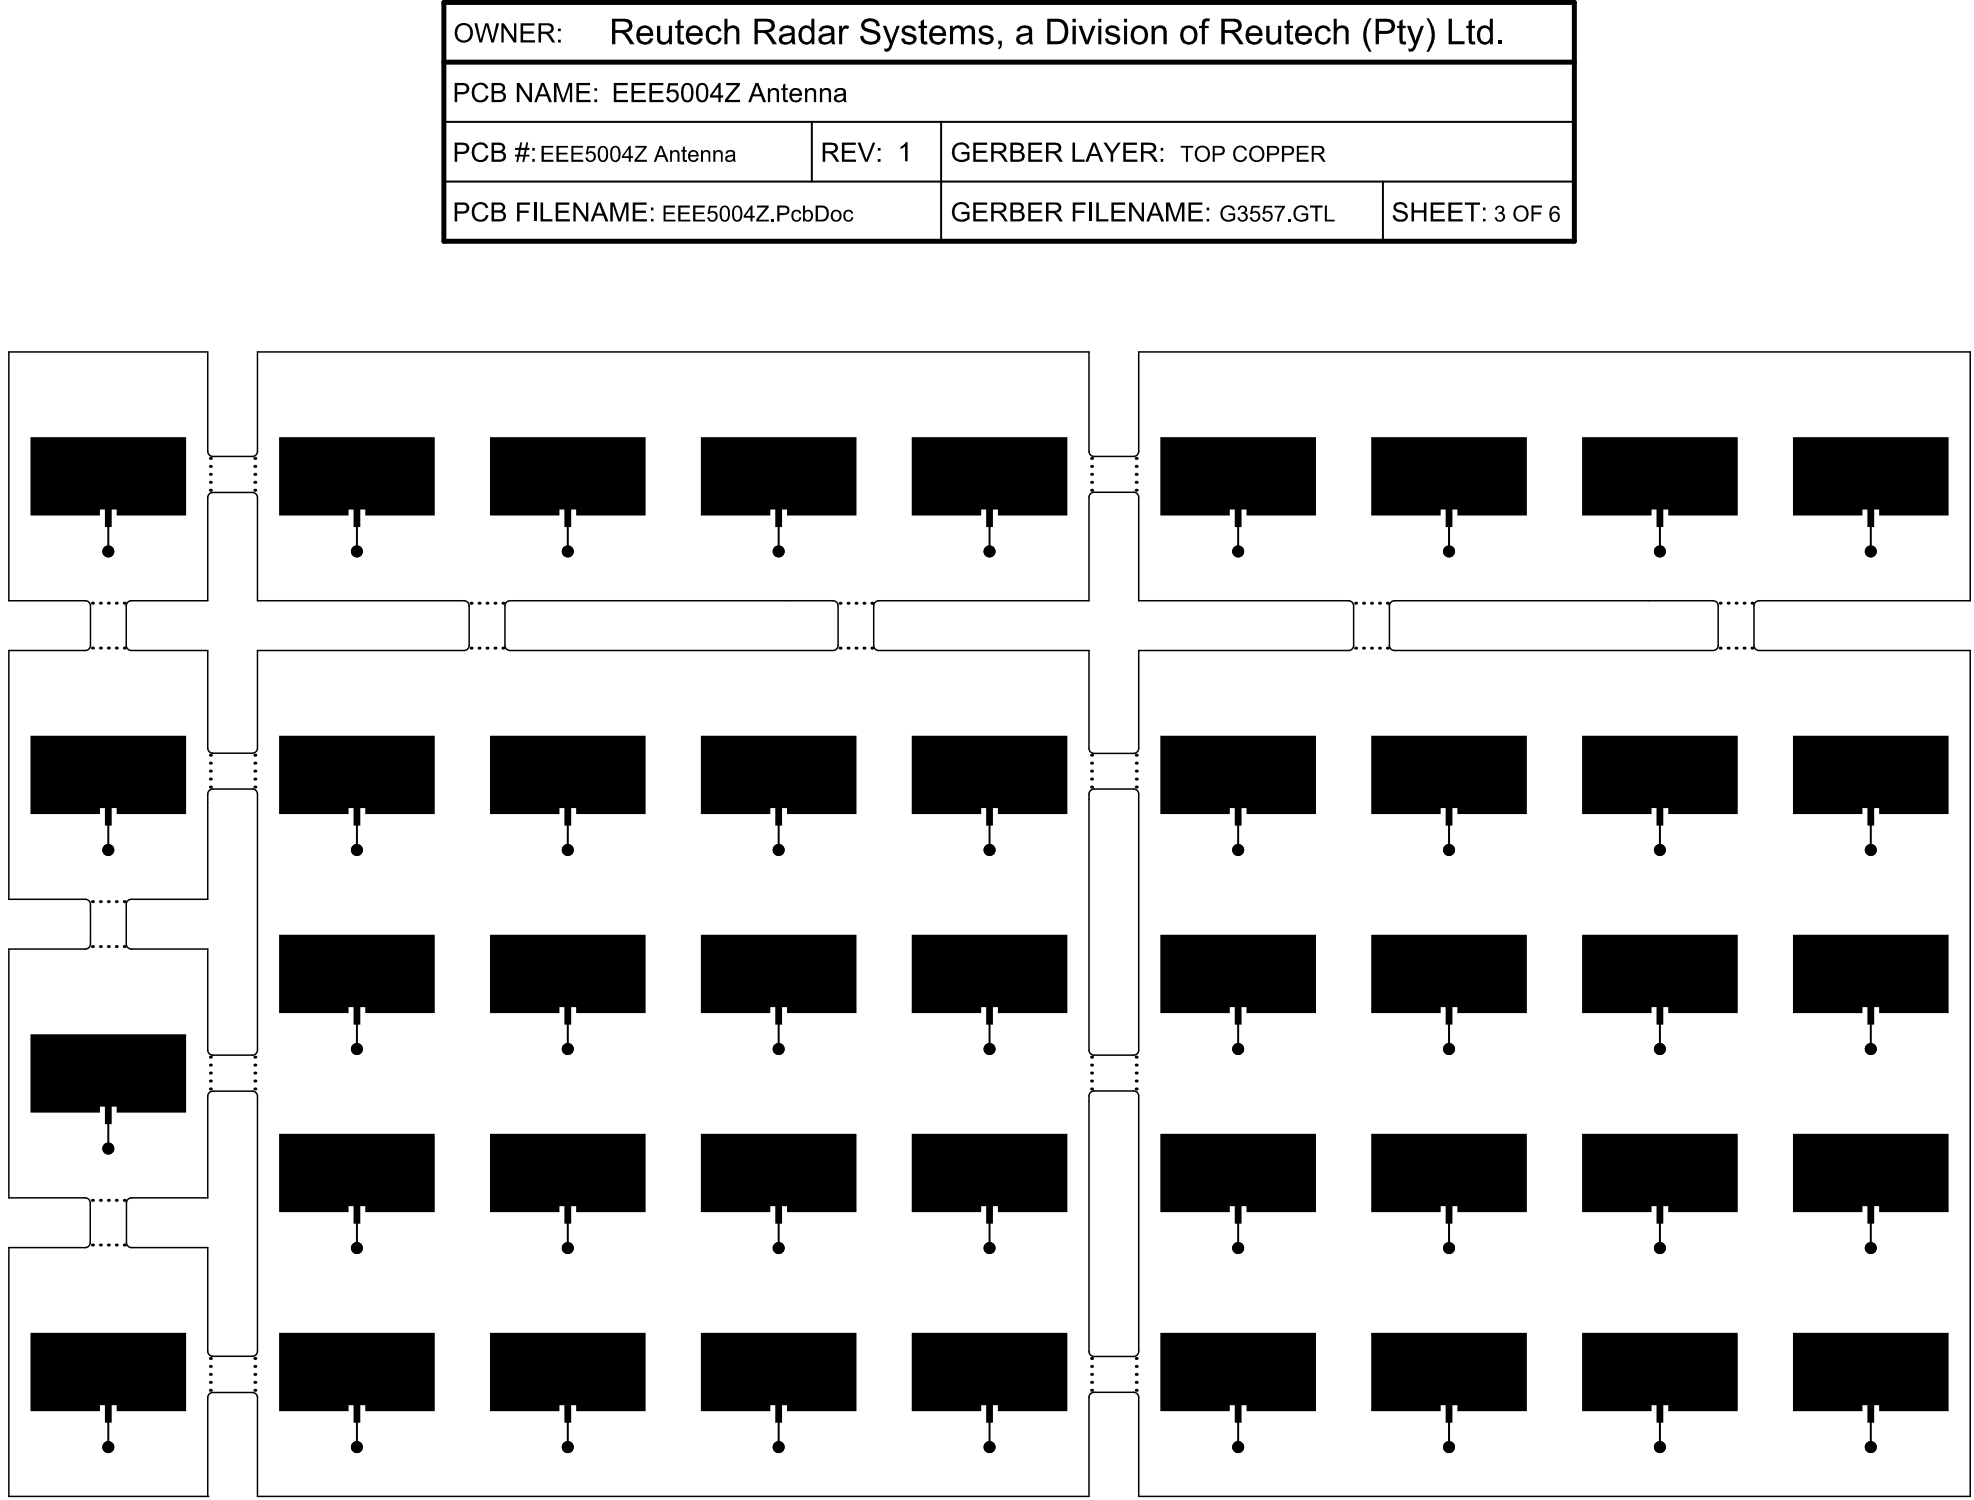
[picture p113: page 1]

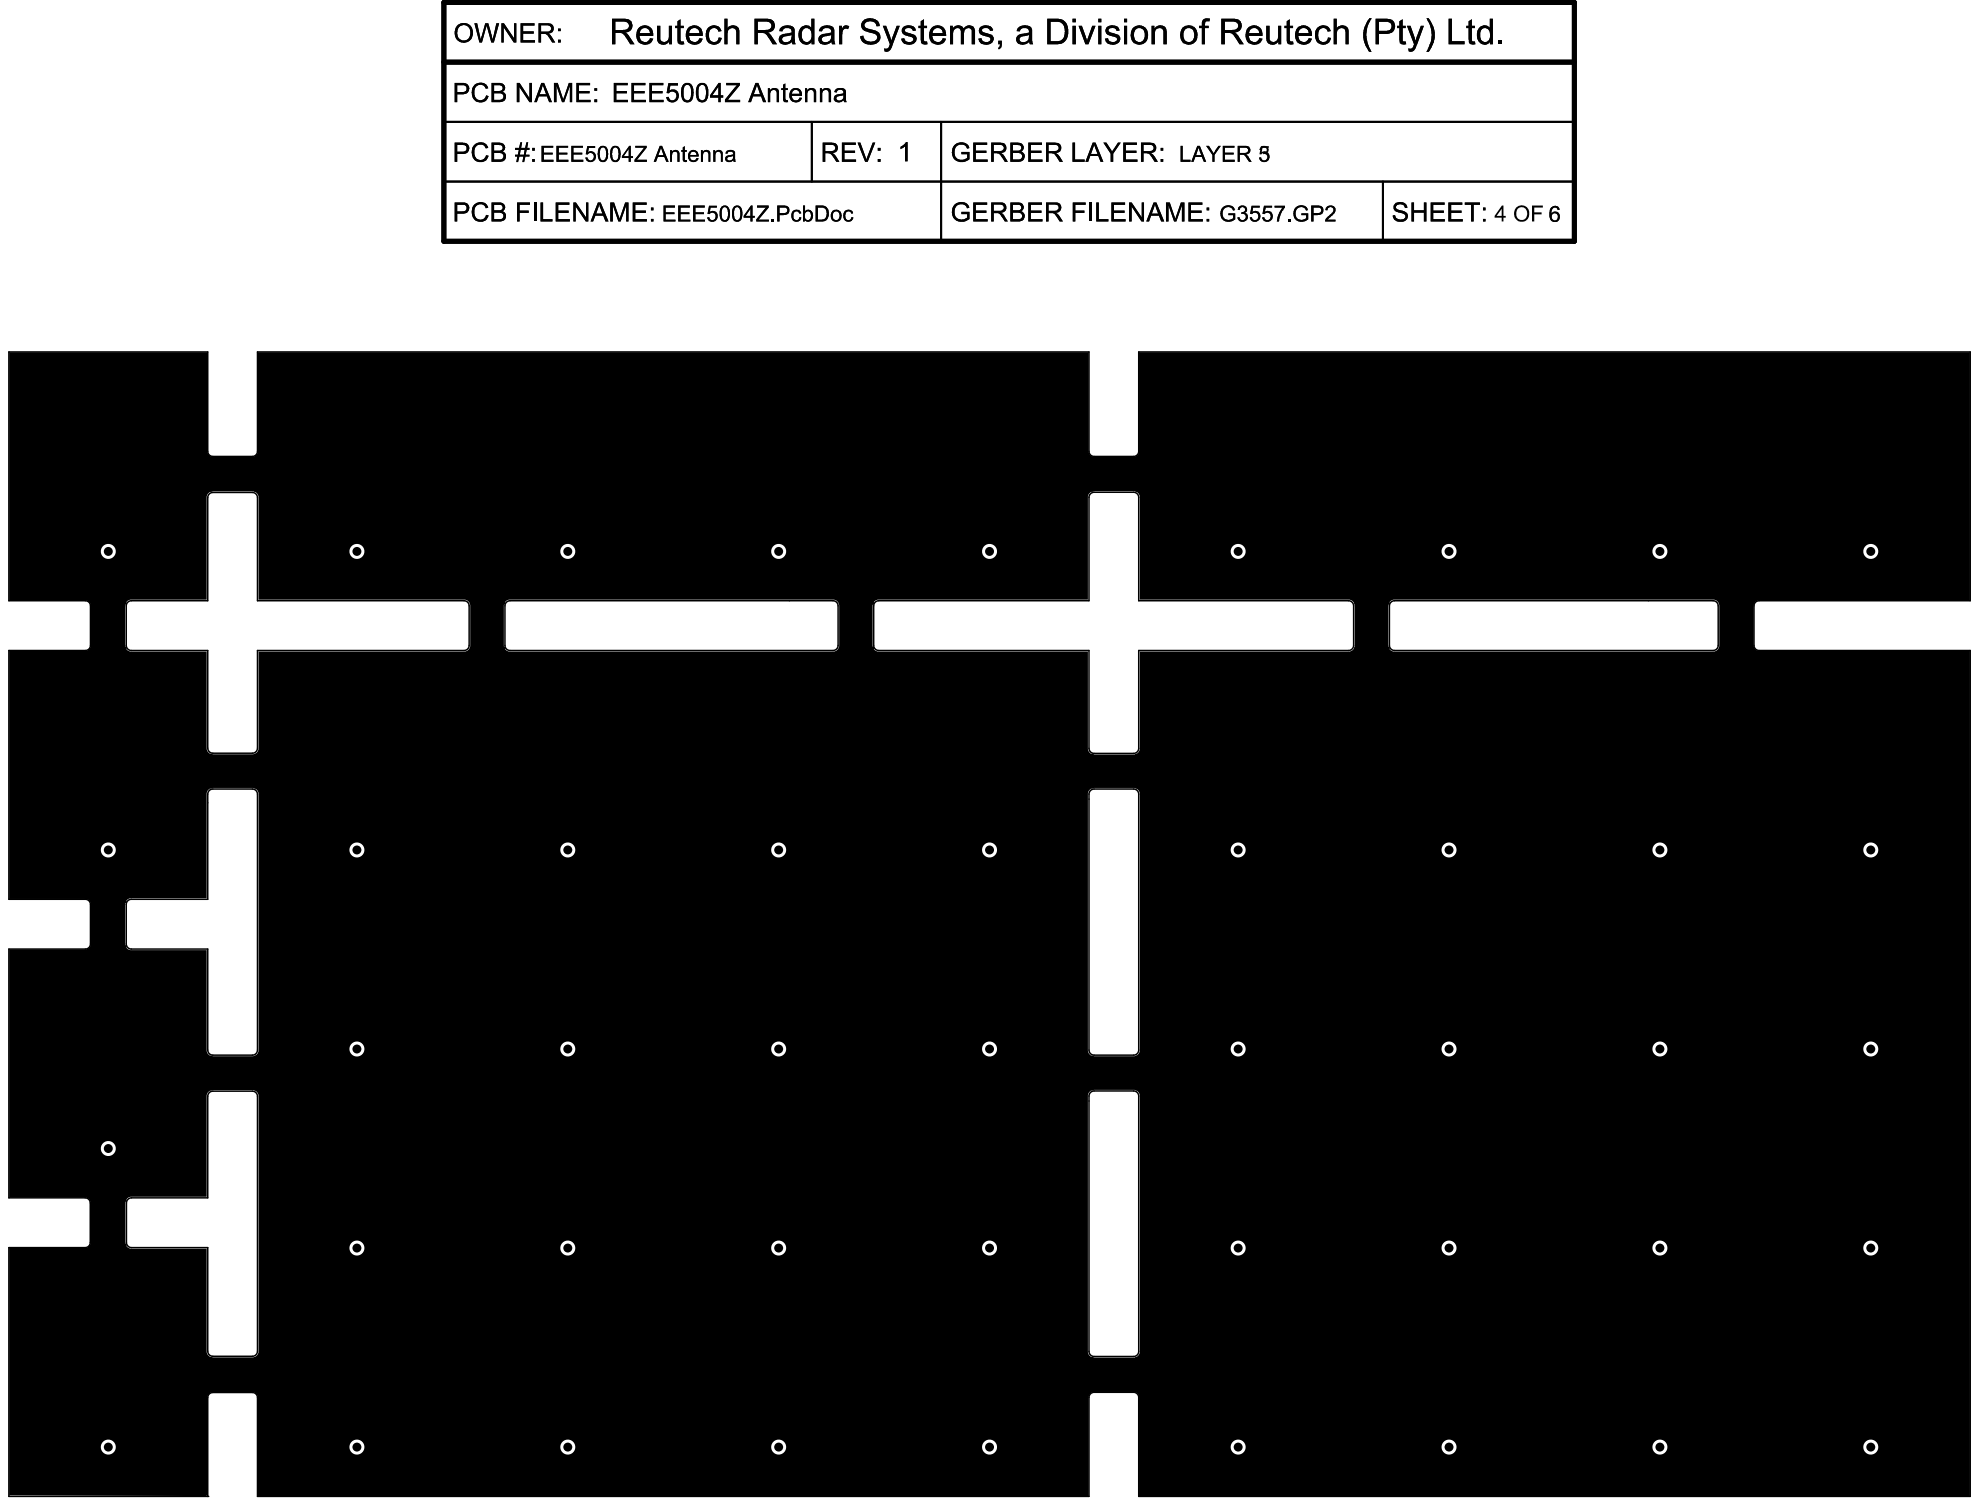
[picture p114: page 2]

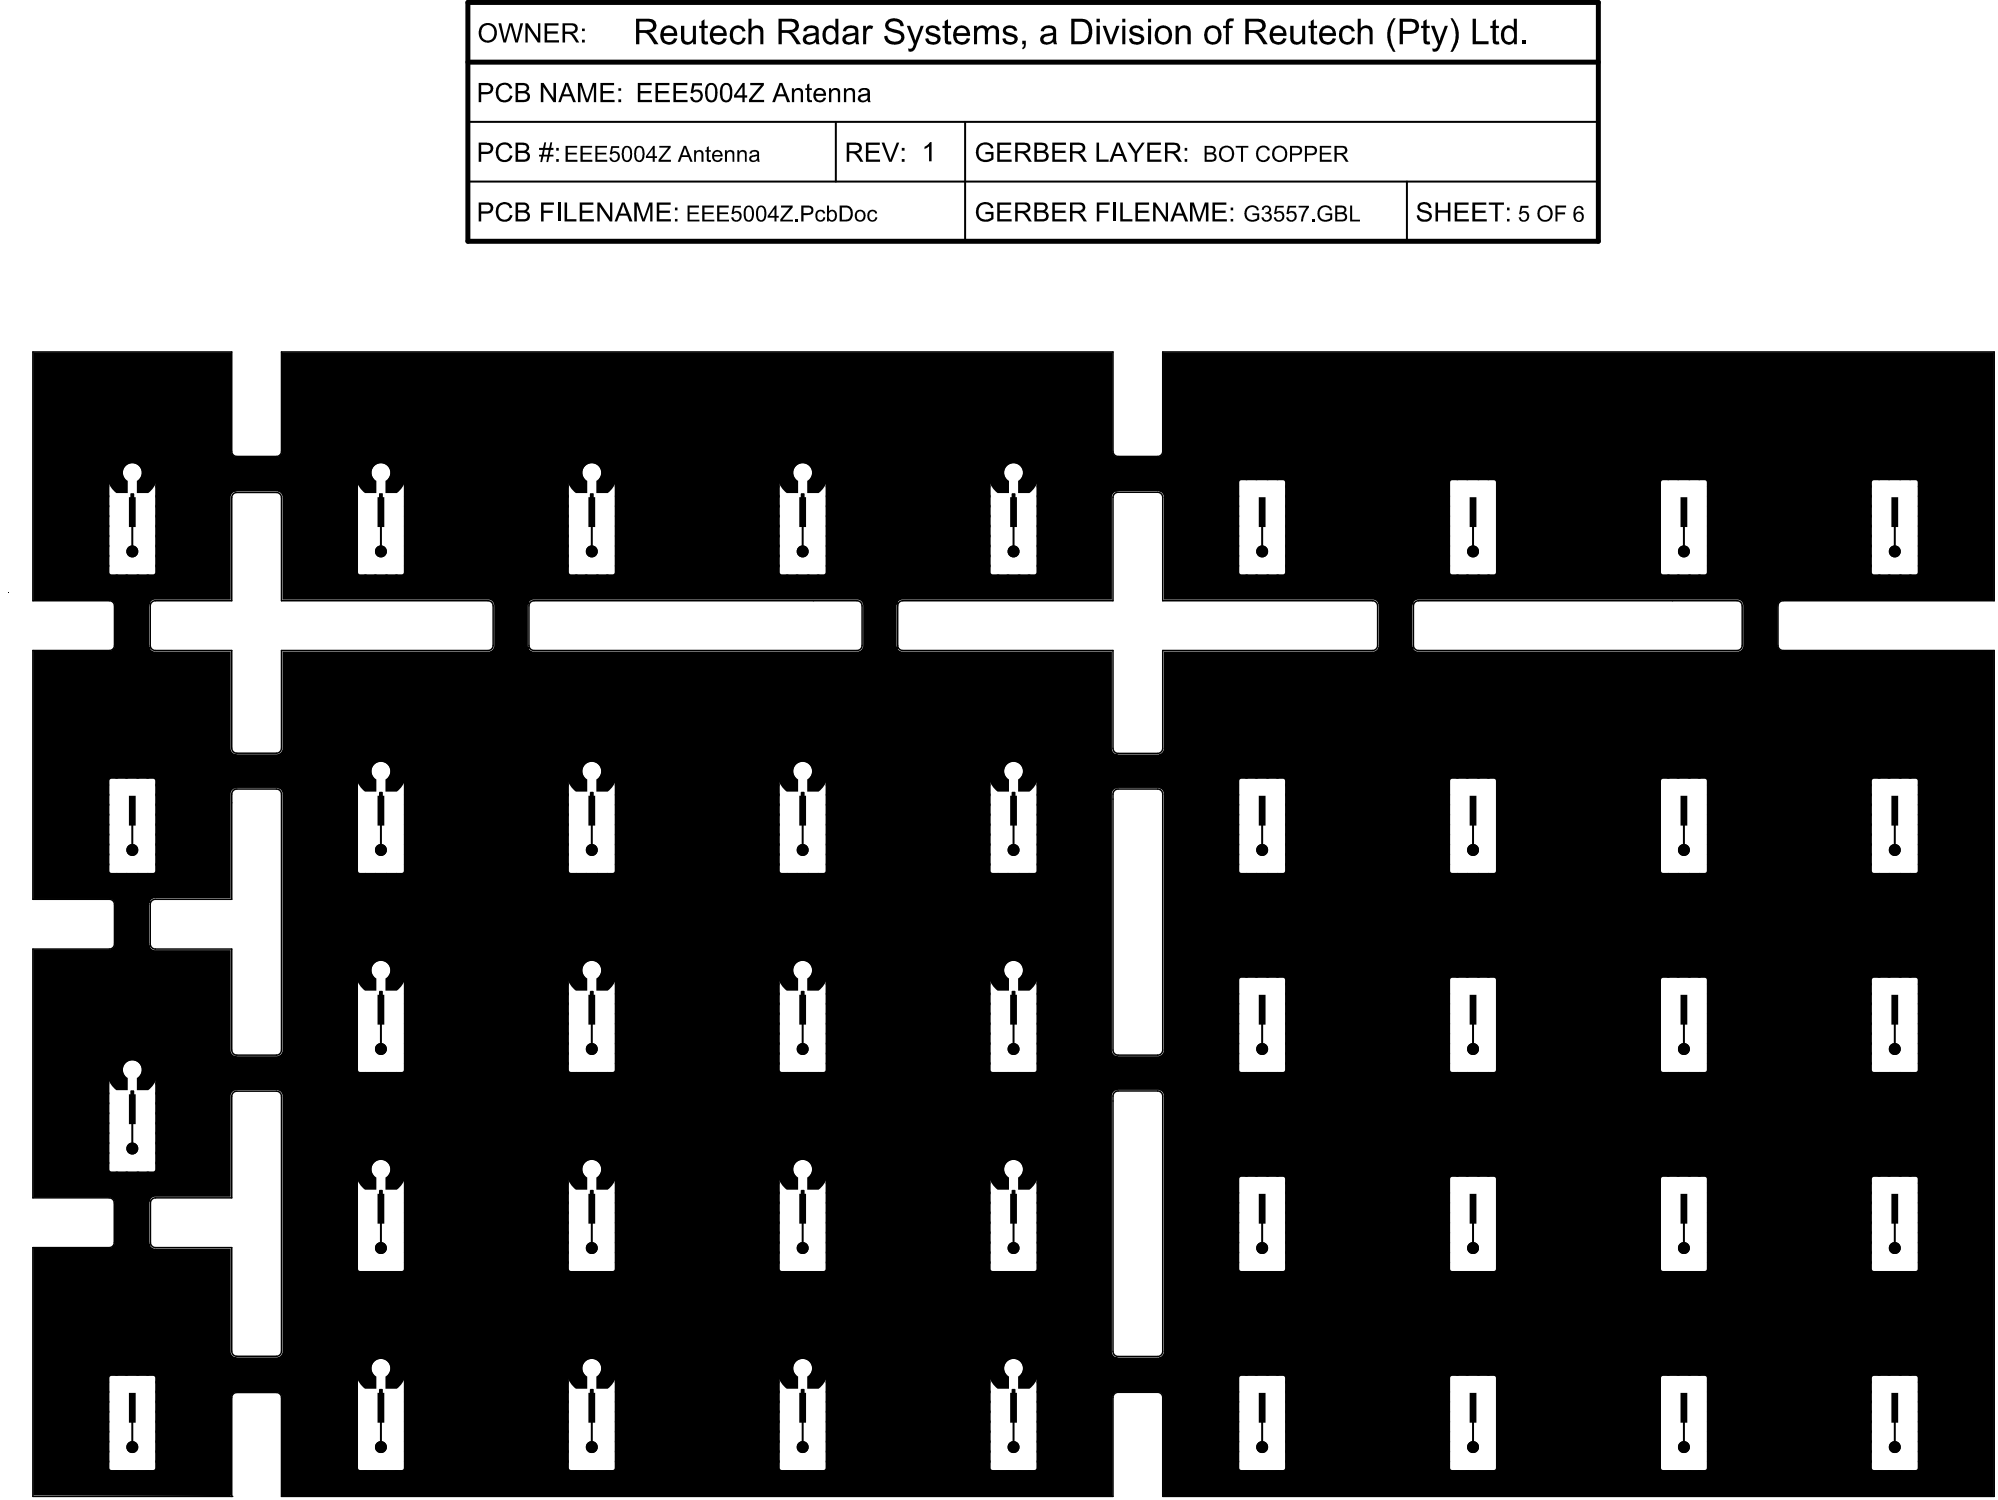
[picture p115: page 3]

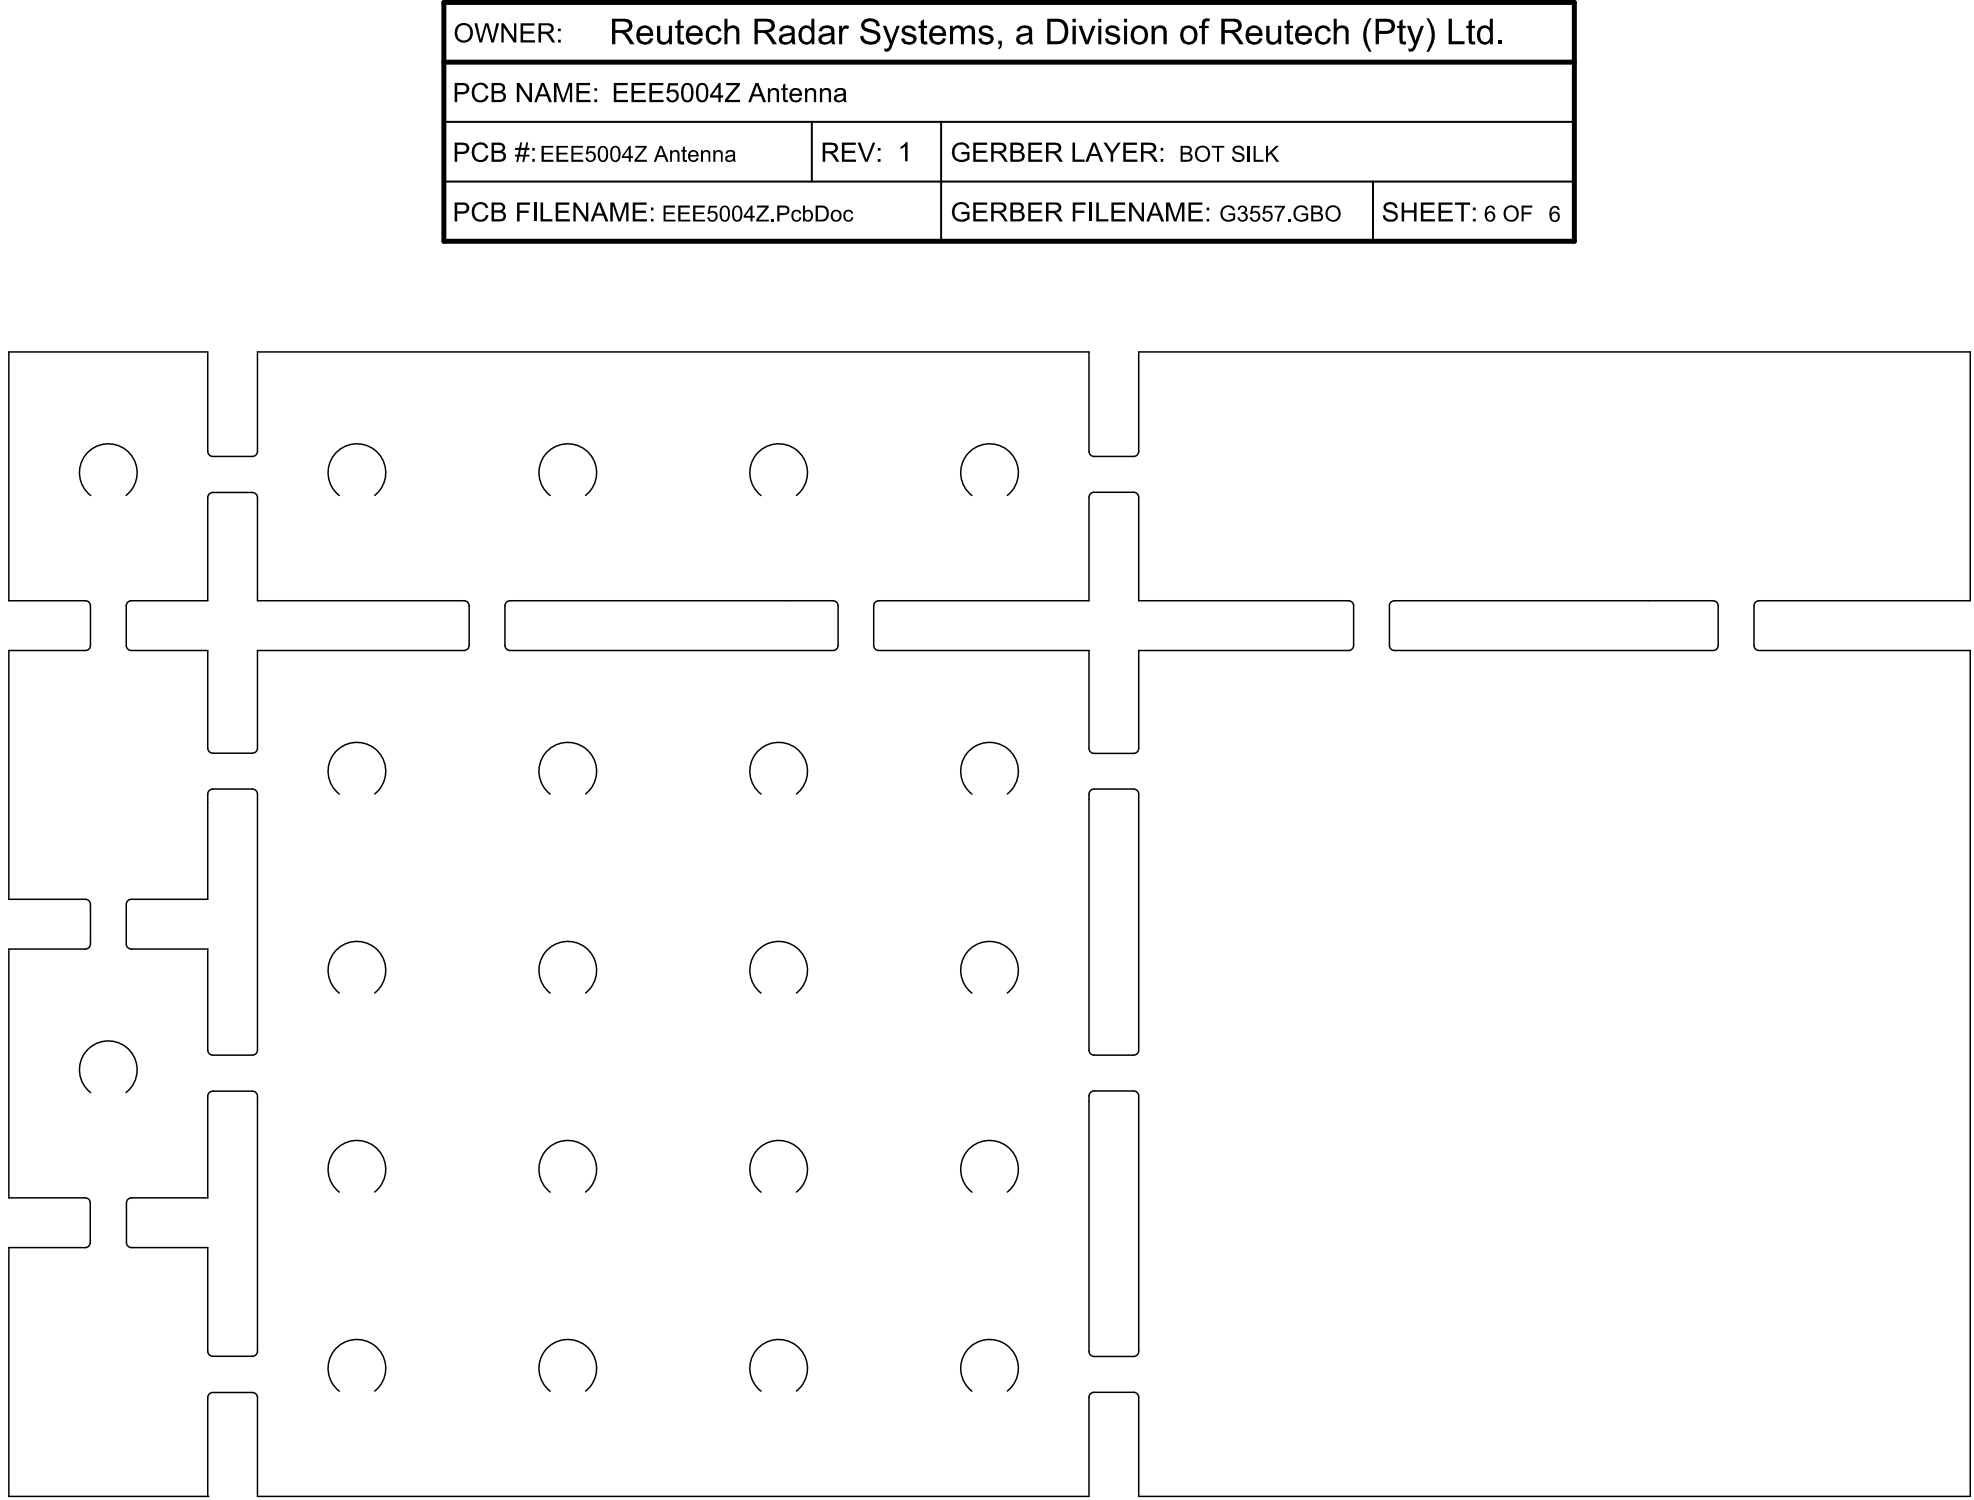
[picture p116: page 4]
