bcj2307/Phase-encoding-a-reflector-array-using-open-and-short-circuited-loads/Altium/01 - Final/G3557_PLT/G3557_PST.PDF

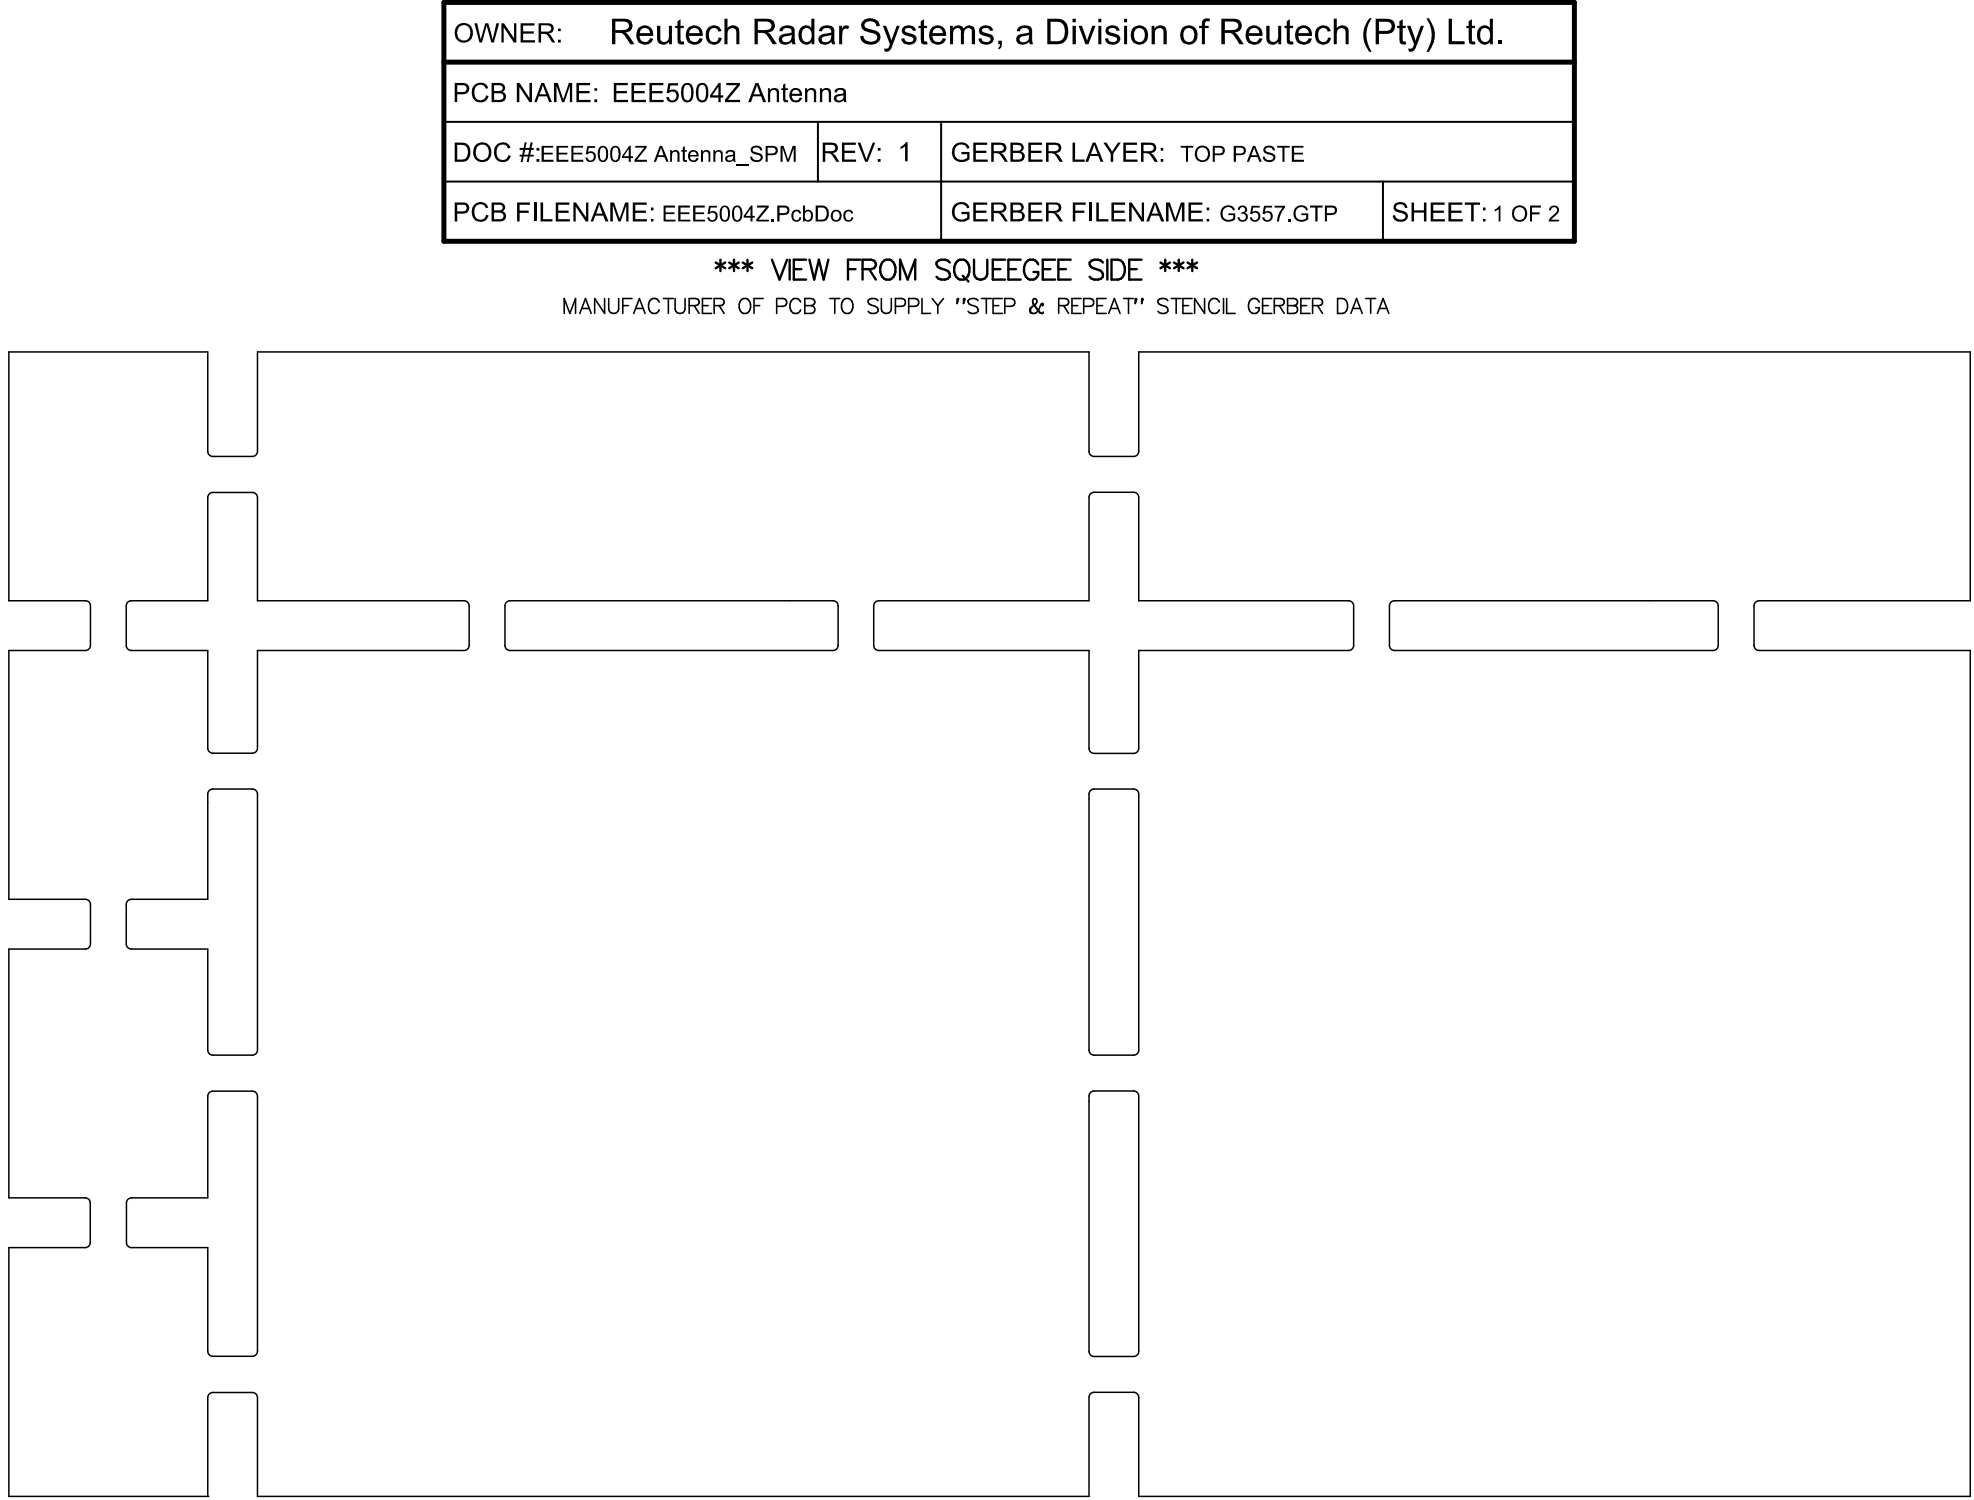
[picture p117: page 1]

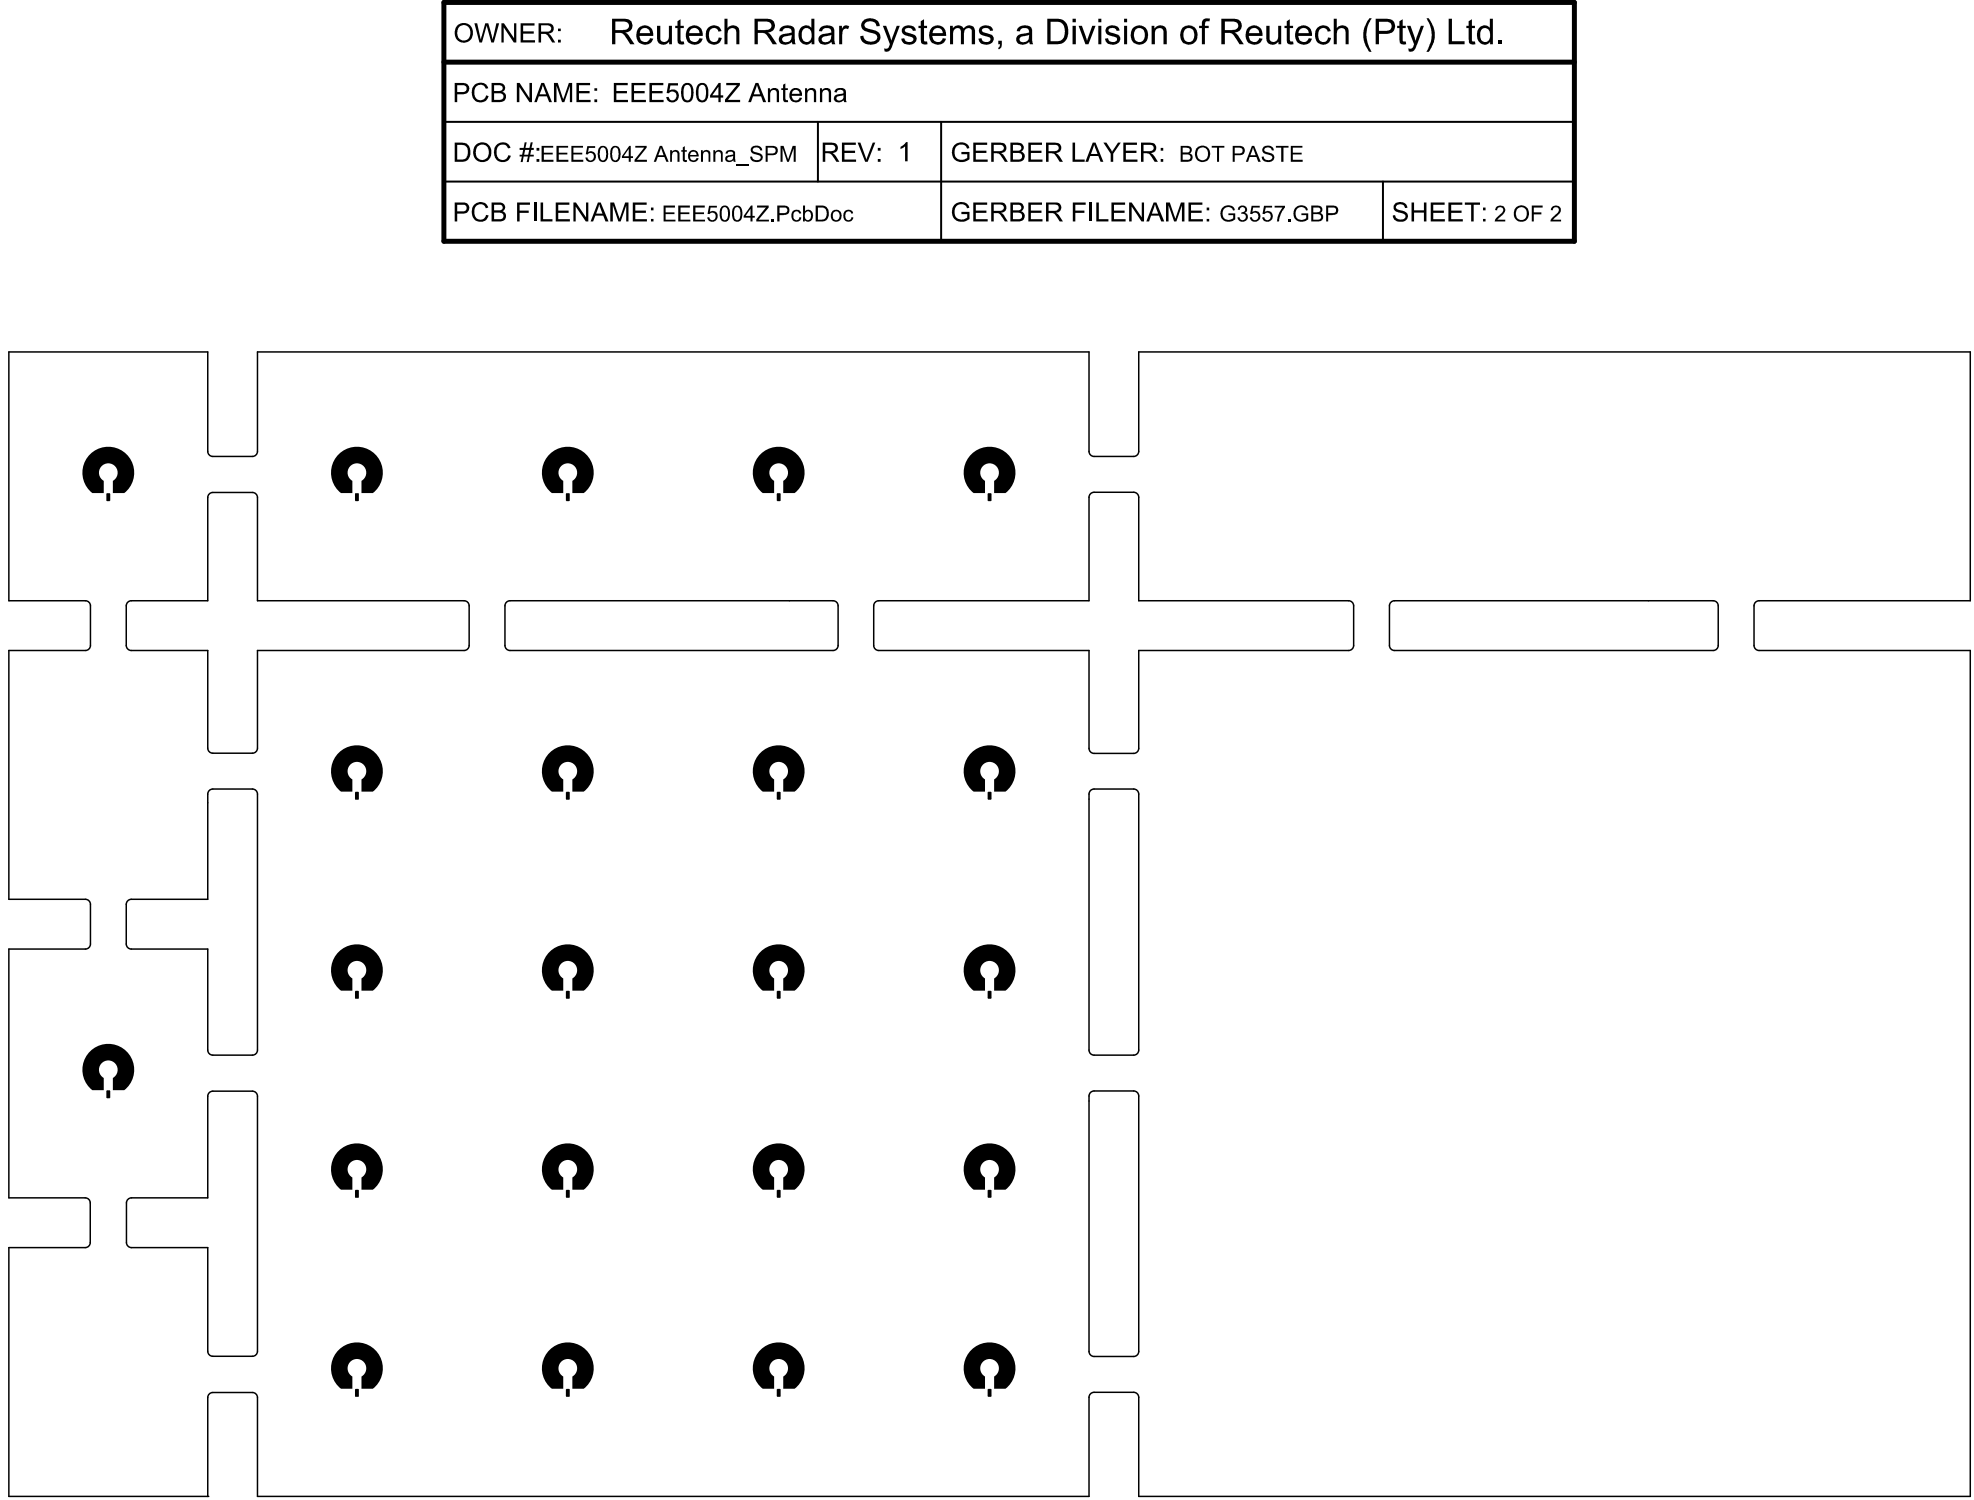
[picture p118: page 2]
