bcj2307/Phase-encoding-a-reflector-array-using-open-and-short-circuited-loads/(list of files, drawings)

Other design files:
Altium/EEE5004Z.PrjPcb
CST/Single Patch/New sub antenna via 180 gnd - 9.7/Model/3D/Model.dsn
CST/Single Patch/New sub antenna via 180 gnd - 9.7/Model/DS/Model.dsn
