bcj2307/Phase-encoding-a-reflector-array-using-open-and-short-circuited-loads/(commit log)

2025-08-01 Added Altium
    [Bill of Materials-EEE5004Z.xlsx, EEE5004Z.PrjPcb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]
2025-08-01 CST single patch results
    [Model.dsn, pinned_variables.cfg]
